squadracorsepolito/sensorboard/Doc/CubeMX_exports/sensor_board.pdf

12/03/2023

sensor_board Project
Configuration Report

## 1. Description

### 1.1. Project

Project Name | sensor_board
Board Name | custom
Generated with: | STM32CubeMX 6.6.1
Date | 03/12/2023

### 1.2. MCU

MCU Series | STM32F4
MCU Line | STM32F446
MCU name | STM32F446RETx
MCU Package | LQFP64
MCU Pin number | 64

### 1.3. Core(s) information

Core(s) | Arm Cortex-M4

## 2. Pinout Configuration

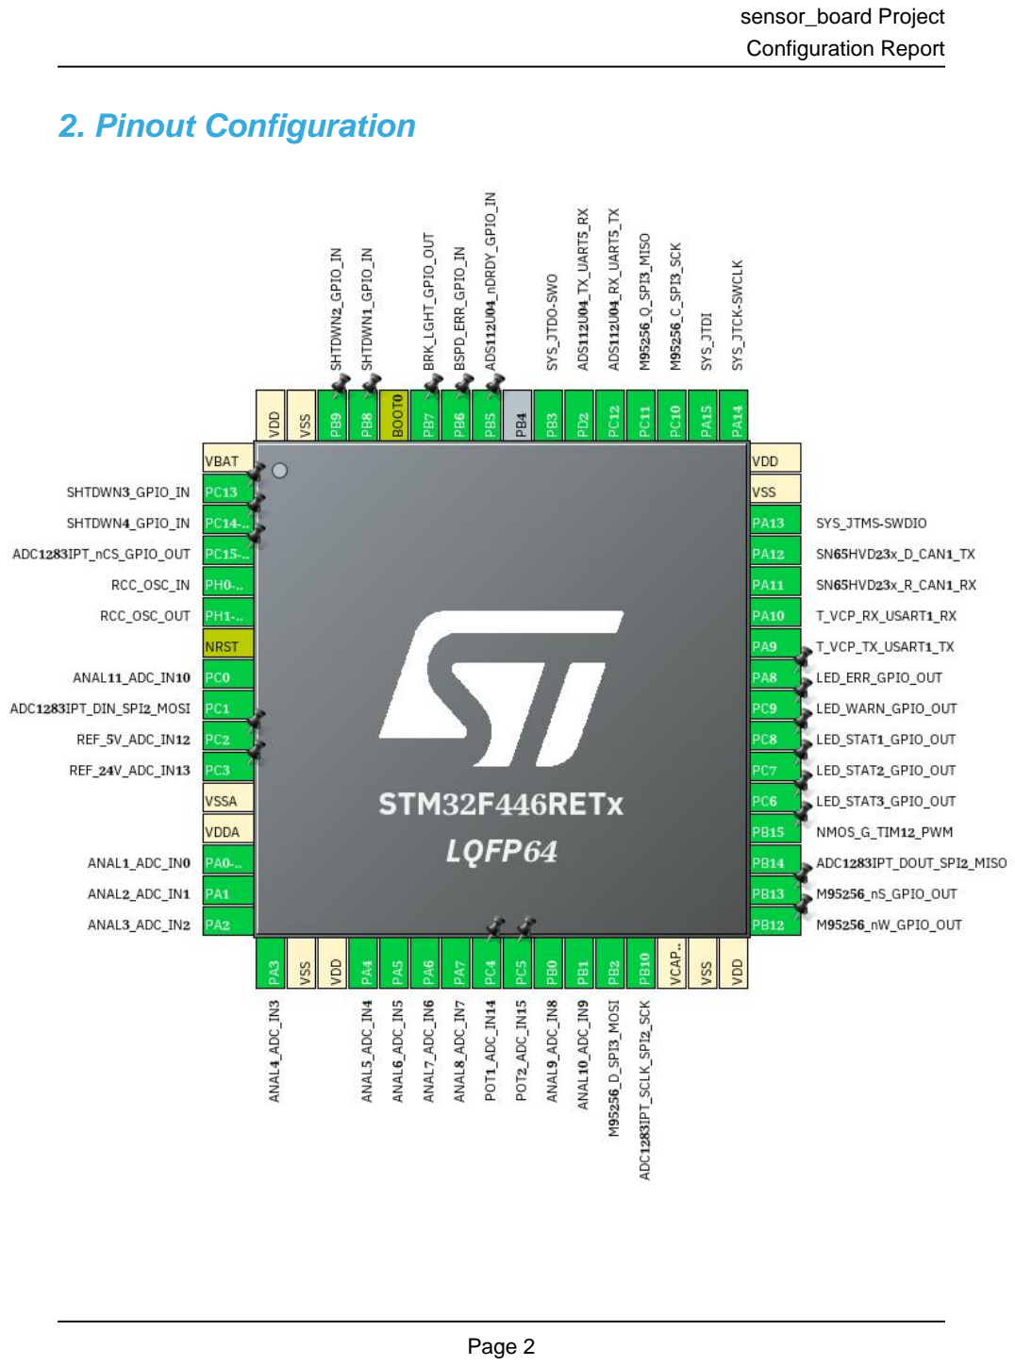
[picture p3: page 3]

## 3. Pins Configuration

Pin Number LQFP64 | Pin Name (function after reset) | Pin Type | Alternate Function(s) | Label
1 | VBAT | Power
2 | PC13 * | I/O | GPIO_Input | SHTDWN3_GPIO_IN
3 | PC14-OSC32_IN * | I/O | GPIO_Input | SHTDWN4_GPIO_IN
4 | PC15-OSC32_OUT * | I/O | GPIO_Output | ADC1283IPT_nCS_GPIO_O UT
5 | PH0-OSC_IN | I/O | RCC_OSC_IN
6 | PH1-OSC_OUT | I/O | RCC_OSC_OUT
7 | NRST | Reset
8 | PC0 | I/O | ADC1_IN10 | ANAL11_ADC_IN10
9 | PC1 | I/O | SPI2_MOSI | ADC1283IPT_DIN_SPI2_M OSI
10 | PC2 | I/O | ADC3_IN12 | REF_5V_ADC_IN12
11 | PC3 | I/O | ADC3_IN13 | REF_24V_ADC_IN13
12 | VSSA | Power
13 | VDDA | Power
14 | PA0-WKUP | I/O | ADC1_IN0 | ANAL1_ADC_IN0
15 | PA1 | I/O | ADC1_IN1 | ANAL2_ADC_IN1
16 | PA2 | I/O | ADC1_IN2 | ANAL3_ADC_IN2
17 | PA3 | I/O | ADC1_IN3 | ANAL4_ADC_IN3
18 | VSS | Power
19 | VDD | Power
20 | PA4 | I/O | ADC1_IN4 | ANAL5_ADC_IN4
21 | PA5 | I/O | ADC1_IN5 | ANAL6_ADC_IN5
22 | PA6 | I/O | ADC1_IN6 | ANAL7_ADC_IN6
23 | PA7 | I/O | ADC1_IN7 | ANAL8_ADC_IN7
24 | PC4 | I/O | ADC2_IN14 | POT1_ADC_IN14
25 | PC5 | I/O | ADC2_IN15 | POT2_ADC_IN15
26 | PB0 | I/O | ADC1_IN8 | ANAL9_ADC_IN8
27 | PB1 | I/O | ADC1_IN9 | ANAL10_ADC_IN9
28 | PB2 | I/O | SPI3_MOSI | M95256_D_SPI3_MOSI
29 | PB10 | I/O | SPI2_SCK | ADC1283IPT_SCLK_SPI2_ SCK
30 | VCAP_1 | Power
31 | VSS | Power
32 | VDD | Power
33 | PB12 * | I/O | GPIO_Output | M95256_nW_GPIO_OUT

Pin Number LQFP64 | Pin Name (function after reset) | Pin Type | Alternate Function(s) | Label
34 | PB13 * | I/O | GPIO_Output | M95256_nS_GPIO_OUT
35 | PB14 | I/O | SPI2_MISO | ADC1283IPT_DOUT_SPI2_ MISO
36 | PB15 | I/O | TIM12_CH2 | NMOS_G_TIM12_PWM
37 | PC6 * | I/O | GPIO_Output | LED_STAT3_GPIO_OUT
38 | PC7 * | I/O | GPIO_Output | LED_STAT2_GPIO_OUT
39 | PC8 * | I/O | GPIO_Output | LED_STAT1_GPIO_OUT
40 | PC9 * | I/O | GPIO_Output | LED_WARN_GPIO_OUT
41 | PA8 * | I/O | GPIO_Output | LED_ERR_GPIO_OUT
42 | PA9 | I/O | USART1_TX | T_VCP_TX_USART1_TX
43 | PA10 | I/O | USART1_RX | T_VCP_RX_USART1_RX
44 | PA11 | I/O | CAN1_RX | SN65HVD23x_R_CAN1_RX
45 | PA12 | I/O | CAN1_TX | SN65HVD23x_D_CAN1_TX
46 | PA13 | I/O | SYS_JTMS-SWDIO
47 | VSS | Power
48 | VDD | Power
49 | PA14 | I/O | SYS_JTCK-SWCLK
50 | PA15 | I/O | SYS_JTDI
51 | PC10 | I/O | SPI3_SCK | M95256_C_SPI3_SCK
52 | PC11 | I/O | SPI3_MISO | M95256_Q_SPI3_MISO
53 | PC12 | I/O | UART5_TX | ADS112U04_RX_UART5_T X
54 | PD2 | I/O | UART5_RX | ADS112U04_TX_UART5_R X
55 | PB3 | I/O | SYS_JTDO-SWO
57 | PB5 | I/O | GPIO_EXTI5 | ADS112U04_nDRDY_GPIO _IN
58 | PB6 * | I/O | GPIO_Input | BSPD_ERR_GPIO_IN
59 | PB7 * | I/O | GPIO_Output | BRK_LGHT_GPIO_OUT
60 | BOOT0 | Boot
61 | PB8 * | I/O | GPIO_Input | SHTDWN1_GPIO_IN
62 | PB9 * | I/O | GPIO_Input | SHTDWN2_GPIO_IN
63 | VSS | Power
64 | VDD | Power

* The pin is affected with an I/O function

## 4. Clock Tree Configuration

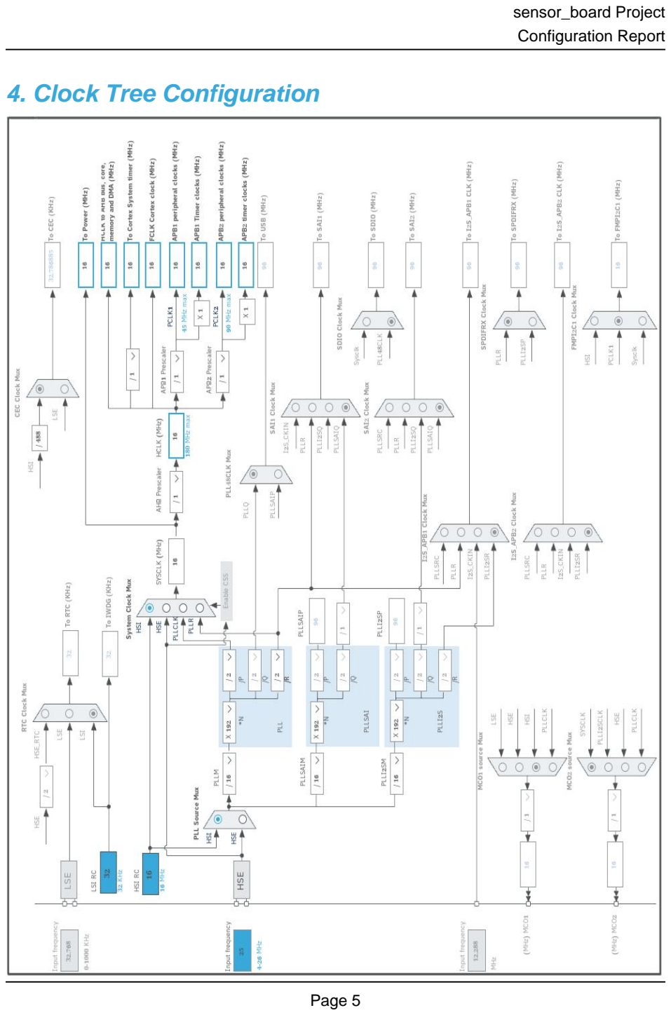
[picture p4: page 6]

## 5. Software Project

### 5.1. Project Settings

Name | Value
Project Name | sensor_board
Project Folder | /home/simone/Documents/10.SquadraCorse/Work/sensor_board
Toolchain / IDE | Makefile
Firmware Package Name and Version | STM32Cube FW_F4 V1.27.1
Application Structure | Advanced
Generate Under Root | No
Do not generate the main() | No
Minimum Heap Size | 0x200
Minimum Stack Size | 0x400

### 5.2. Code Generation Settings

Name | Value
STM32Cube MCU packages and embedded software | Copy all used libraries into the project folder
Generate peripheral initialization as a pair of '.c/.h' files | Yes
Backup previously generated files when re-generating | Yes
Keep User Code when re-generating | Yes
Delete previously generated files when not re-generated | Yes
Set all free pins as analog (to optimize the power consumption) | No
Enable Full Assert | No

### 5.3. Advanced Settings - Generated Function Calls

Rank | Function Name | Peripheral Instance Name
1 | SystemClock_Config | RCC
2 | MX_GPIO_Init | GPIO
3 | MX_ADC1_Init | ADC1
4 | MX_CAN1_Init | CAN1
5 | MX_ADC2_Init | ADC2
6 | MX_SPI2_Init | SPI2
7 | MX_SPI3_Init | SPI3
8 | MX_UART5_Init | UART5
9 | MX_USART1_UART_Init | USART1
10 | MX_ADC3_Init | ADC3
11 | MX_TIM12_Init | TIM12

## 6. Power Consumption Calculator report

### 6.1. Microcontroller Selection

Series | STM32F4
Line | STM32F446
MCU | STM32F446RETx
Datasheet | DS10693_Rev6

### 6.2. Parameter Selection

Temperature | 25
Vdd | 3.3

### 6.3. Battery Selection

Battery | Li-SOCL2(A3400)
Capacity | 3400.0 mAh
Self Discharge | 0.08 %/month
Nominal Voltage | 3.6 V
Max Cont Current | 100.0 mA
Max Pulse Current | 200.0 mA
Cells in series | 1
Cells in parallel | 1

### 6.4. Sequence

Step | Step1 | Step2
Mode | RUN | STOP_UDM (Under Drive)
Vdd | 3.3 | 3.3
Voltage Source | Battery | Battery
Range | Scale1-High | No Scale
Fetch Type | RAM/FLASH/REGON/ART/P REFETCH | n/a
CPU Frequency | 180 MHz | 0 Hz
Clock Configuration | HSE PLL | Regulator_LP Flash-PwrDwn
Clock Source Frequency | 4 MHz | 0 Hz
Peripherals
Additional Cons. | 0 mA | 0 mA
Average Current | 46 mA | 55 µA
Duration | 0.1 ms | 0.9 ms
DMIPS | 225.0 | 0.0
Ta Max | 98.02 | 104.99
Category | In DS Table | In DS Table

### 6.5. Results

Sequence Time | 1 ms | Average Current | 4.65 mA
Battery Life | 1 month | Average DMIPS | 225.0 DMIPS

### 6.6. Chart

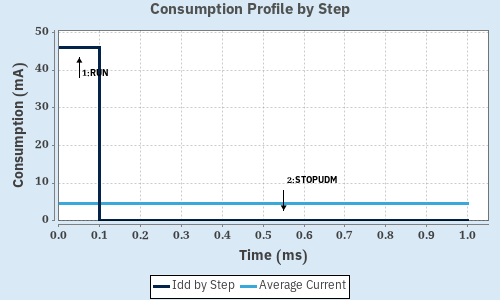
[picture p5: figure]

## 7. Peripherals and Middlewares Configuration

### 7.1. ADC1

mode: IN0
mode: IN1
mode: IN2
mode: IN3
mode: IN4
mode: IN5
mode: IN6
mode: IN7
mode: IN8
mode: IN9
mode: IN10
7.1.1. Parameter Settings:

ADCs_Common_Settings:

Mode | Independent mode
ADC_Settings:
Clock Prescaler | PCLK2 divided by 2
Resolution | 12 bits (15 ADC Clock cycles)
Data Alignment | Right alignment
Scan Conversion Mode | Disabled
Continuous Conversion Mode | Disabled
Discontinuous Conversion Mode | Disabled
DMA Continuous Requests | Disabled
End Of Conversion Selection | EOC flag at the end of single channel conversion
ADC_Regular_ConversionMode:
Number Of Conversion | 1
External Trigger Conversion Source | Regular Conversion launched by software
External Trigger Conversion Edge | None
Rank | 1
Channel | Channel 0
Sampling Time | 3 Cycles
ADC_Injected_ConversionMode:
Number Of Conversions | 0
WatchDog:
Enable Analog WatchDog Mode | false

### 7.2. ADC2

mode: IN14
mode: IN15
7.2.1. Parameter Settings:

ADCs_Common_Settings:

Mode | Independent mode
ADC_Settings:
Clock Prescaler | PCLK2 divided by 2
Resolution | 12 bits (15 ADC Clock cycles)
Data Alignment | Right alignment
Scan Conversion Mode | Disabled
Continuous Conversion Mode | Disabled
Discontinuous Conversion Mode | Disabled
DMA Continuous Requests | Disabled
End Of Conversion Selection | EOC flag at the end of single channel conversion
ADC_Regular_ConversionMode:
Number Of Conversion | 1
External Trigger Conversion Source | Regular Conversion launched by software
External Trigger Conversion Edge | None
Rank | 1
Channel | Channel 14
Sampling Time | 3 Cycles
ADC_Injected_ConversionMode:
Number Of Conversions | 0
WatchDog:
Enable Analog WatchDog Mode | false

### 7.3. ADC3

mode: IN12
mode: IN13
7.3.1. Parameter Settings:

ADC_Settings:

Clock Prescaler | PCLK2 divided by 2
Resolution | 12 bits (15 ADC Clock cycles)

Data Alignment | Right alignment
Scan Conversion Mode | Disabled
Continuous Conversion Mode | Disabled
Discontinuous Conversion Mode | Disabled
DMA Continuous Requests | Disabled
End Of Conversion Selection | EOC flag at the end of single channel conversion
ADC_Regular_ConversionMode:
Number Of Conversion | 1
External Trigger Conversion Source | Regular Conversion launched by software
External Trigger Conversion Edge | None
Rank | 1
Channel | Channel 12
Sampling Time | 3 Cycles
ADC_Injected_ConversionMode:
Number Of Conversions | 0
WatchDog:
Enable Analog WatchDog Mode | false

### 7.4. CAN1

mode: Activated
7.4.1. Parameter Settings:

Bit Timings Parameters:

Prescaler (for Time Quantum) | 16
Time Quantum | 1000.0 *
Time Quanta in Bit Segment 1 | 1 Time
Time Quanta in Bit Segment 2 | 1 Time
Time for one Bit | 3000 *
Baud Rate | 333333 *
ReSynchronization Jump Width | 1 Time
Basic Parameters:
Time Triggered Communication Mode | Disable
Automatic Bus-Off Management | Disable
Automatic Wake-Up Mode | Disable
Automatic Retransmission | Disable
Receive Fifo Locked Mode | Disable
Transmit Fifo Priority | Disable
Advanced Parameters:
Operating Mode | Normal

### 7.5. RCC

High Speed Clock (HSE): Crystal/Ceramic Resonator
7.5.1. Parameter Settings:

System Parameters:

VDD voltage (V) | 3.3
Instruction Cache | Enabled
Prefetch Buffer | Enabled
Data Cache | Enabled
Flash Latency(WS) | 0 WS (1 CPU cycle)
RCC Parameters:
HSI Calibration Value | 16
TIM Prescaler Selection | Disabled
HSE Startup Timout Value (ms) | 100
LSE Startup Timout Value (ms) | 5000
Power Parameters:
Power Regulator Voltage Scale | Power Regulator Voltage Scale 3
Power Over Drive | Disabled

### 7.6. SPI2

Mode: Full-Duplex Master
7.6.1. Parameter Settings:

Basic Parameters:

Frame Format | Motorola
Data Size | 8 Bits
First Bit | MSB First
Clock Parameters:
Prescaler (for Baud Rate) | 2
Baud Rate | 8.0 MBits/s *
Clock Polarity (CPOL) | Low
Clock Phase (CPHA) | 1 Edge
Advanced Parameters:
CRC Calculation | Disabled
NSS Signal Type | Software

### 7.7. SPI3

Mode: Full-Duplex Master
7.7.1. Parameter Settings:

Basic Parameters:

Frame Format | Motorola
Data Size | 8 Bits
First Bit | MSB First
Clock Parameters:
Prescaler (for Baud Rate) | 2
Baud Rate | 8.0 MBits/s *
Clock Polarity (CPOL) | Low
Clock Phase (CPHA) | 1 Edge
Advanced Parameters:
CRC Calculation | Disabled
NSS Signal Type | Software

### 7.8. SYS

Debug: JTAG (4 pins)
Timebase Source: SysTick

### 7.9. TIM12

Trigger Source: ITR0
Channel2: PWM Generation CH2
7.9.1. Parameter Settings:

Counter Settings:

Prescaler (PSC - 16 bits value) | 0
Counter Mode | Up
Counter Period (AutoReload Register - 16 bits value ) | 65535
Internal Clock Division (CKD) | No Division
auto-reload preload | Disable
Slave Mode Controller | Slave mode disable
PWM Generation Channel 2:
Mode | PWM mode 1

Pulse (16 bits value) | 0
Output compare preload | Enable
Fast Mode | Disable
CH Polarity | High

### 7.10. UART5

Mode: Asynchronous
7.10.1. Parameter Settings:

Basic Parameters:

Baud Rate | 115200
Word Length | 8 Bits (including Parity)
Parity | None
Stop Bits | 1
Advanced Parameters:
Data Direction | Receive and Transmit
Over Sampling | 16 Samples

### 7.11. USART1

Mode: Asynchronous
7.11.1. Parameter Settings:

Basic Parameters:

Baud Rate | 115200
Word Length | 8 Bits (including Parity)
Parity | None
Stop Bits | 1
Advanced Parameters:
Data Direction | Receive and Transmit
Over Sampling | 16 Samples

* User modified value

## 8. System Configuration

### 8.1. GPIO configuration

IP | Pin | Signal | GPIO mode | GPIO pull/up pull down

Max
Speed

User Label

ADC1 | PC0 | ADC1_IN10 | Analog mode | No pull-up and no pull-down | n/a | ANAL11_ADC_IN10
| PA0-WKUP | ADC1_IN0 | Analog mode | No pull-up and no pull-down | n/a | ANAL1_ADC_IN0
| PA1 | ADC1_IN1 | Analog mode | No pull-up and no pull-down | n/a | ANAL2_ADC_IN1
| PA2 | ADC1_IN2 | Analog mode | No pull-up and no pull-down | n/a | ANAL3_ADC_IN2
| PA3 | ADC1_IN3 | Analog mode | No pull-up and no pull-down | n/a | ANAL4_ADC_IN3
| PA4 | ADC1_IN4 | Analog mode | No pull-up and no pull-down | n/a | ANAL5_ADC_IN4
| PA5 | ADC1_IN5 | Analog mode | No pull-up and no pull-down | n/a | ANAL6_ADC_IN5
| PA6 | ADC1_IN6 | Analog mode | No pull-up and no pull-down | n/a | ANAL7_ADC_IN6
| PA7 | ADC1_IN7 | Analog mode | No pull-up and no pull-down | n/a | ANAL8_ADC_IN7
| PB0 | ADC1_IN8 | Analog mode | No pull-up and no pull-down | n/a | ANAL9_ADC_IN8
| PB1 | ADC1_IN9 | Analog mode | No pull-up and no pull-down | n/a | ANAL10_ADC_IN9
ADC2 | PC4 | ADC2_IN14 | Analog mode | No pull-up and no pull-down | n/a | POT1_ADC_IN14
| PC5 | ADC2_IN15 | Analog mode | No pull-up and no pull-down | n/a | POT2_ADC_IN15
ADC3 | PC2 | ADC3_IN12 | Analog mode | No pull-up and no pull-down | n/a | REF_5V_ADC_IN12
| PC3 | ADC3_IN13 | Analog mode | No pull-up and no pull-down | n/a | REF_24V_ADC_IN13
CAN1 | PA11 | CAN1_RX | Alternate Function Push Pull | No pull-up and no pull-down | Very High
*
| | | | | | SN65HVD23x_R_CAN1_R X
| PA12 | CAN1_TX | Alternate Function Push Pull | No pull-up and no pull-down | Very High
*
| | | | | | SN65HVD23x_D_CAN1_T X
RCC | PH0- OSC_IN | RCC_OSC_IN | n/a | n/a | n/a
| PH1- OSC_OUT | RCC_OSC_OUT | n/a | n/a | n/a
SPI2 | PC1 | SPI2_MOSI | Alternate Function Push Pull | No pull-up and no pull-down | Very High
*
| | | | | | ADC1283IPT_DIN_SPI2_ MOSI
| PB10 | SPI2_SCK | Alternate Function Push Pull | No pull-up and no pull-down | Very High
*
| | | | | | ADC1283IPT_SCLK_SPI2 _SCK
| PB14 | SPI2_MISO | Alternate Function Push Pull | No pull-up and no pull-down | Very High
*
| | | | | | ADC1283IPT_DOUT_SPI2 _MISO
SPI3 | PB2 | SPI3_MOSI | Alternate Function Push Pull | No pull-up and no pull-down | Very High
*
| | | | | | M95256_D_SPI3_MOSI
| PC10 | SPI3_SCK | Alternate Function Push Pull | No pull-up and no pull-down | Very High
*
| | | | | | M95256_C_SPI3_SCK
| PC11 | SPI3_MISO | Alternate Function Push Pull | No pull-up and no pull-down | Very High
*
| | | | | | M95256_Q_SPI3_MISO

IP | Pin | Signal | GPIO mode | GPIO pull/up pull down | Max Speed | User Label
SYS | PA13 | SYS_JTMS-SWDIO | n/a | n/a | n/a
| PA14 | SYS_JTCK-SWCLK | n/a | n/a | n/a
| PA15 | SYS_JTDI | n/a | n/a | n/a
| PB3 | SYS_JTDO-SWO | n/a | n/a | n/a
TIM12 | PB15 | TIM12_CH2 | Alternate Function Push Pull | No pull-up and no pull-down | Low | NMOS_G_TIM12_PWM
UART5 | PC12 | UART5_TX | Alternate Function Push Pull | No pull-up and no pull-down | Very High * | ADS112U04_RX_UART5_ TX
| PD2 | UART5_RX | Alternate Function Push Pull | No pull-up and no pull-down | Very High * | ADS112U04_TX_UART5_ RX
USART1 | PA9 | USART1_TX | Alternate Function Push Pull | No pull-up and no pull-down | Very High * | T_VCP_TX_USART1_TX
| PA10 | USART1_RX | Alternate Function Push Pull | No pull-up and no pull-down | Very High * | T_VCP_RX_USART1_RX
GPIO | PC13 | GPIO_Input | Input mode | No pull-up and no pull-down | n/a | SHTDWN3_GPIO_IN
PC14-OSC32_IN | GPIO_Input | Input mode | No pull-up and no pull-down | n/a | SHTDWN4_GPIO_IN
PC15-OSC32_OU T | GPIO_Output | Output Push Pull | No pull-up and no pull-down | Low | ADC1283IPT_nCS_GPIO_ OUT
PB12 | GPIO_Output | Output Push Pull | No pull-up and no pull-down | Low | M95256_nW_GPIO_OUT
PB13 | GPIO_Output | Output Push Pull | No pull-up and no pull-down | Low | M95256_nS_GPIO_OUT
PC6 | GPIO_Output | Output Push Pull | No pull-up and no pull-down | Low | LED_STAT3_GPIO_OUT
PC7 | GPIO_Output | Output Push Pull | No pull-up and no pull-down | Low | LED_STAT2_GPIO_OUT
PC8 | GPIO_Output | Output Push Pull | No pull-up and no pull-down | Low | LED_STAT1_GPIO_OUT
PC9 | GPIO_Output | Output Push Pull | No pull-up and no pull-down | Low | LED_WARN_GPIO_OUT
PA8 | GPIO_Output | Output Push Pull | No pull-up and no pull-down | Low | LED_ERR_GPIO_OUT
PB5 | GPIO_EXTI5 | External Interrupt Mode with Rising edge trigger detection | No pull-up and no pull-down | n/a | ADS112U04_nDRDY_GPI O_IN
PB6 | GPIO_Input | Input mode | No pull-up and no pull-down | n/a | BSPD_ERR_GPIO_IN
PB7 | GPIO_Output | Output Push Pull | No pull-up and no pull-down | Low | BRK_LGHT_GPIO_OUT
PB8 | GPIO_Input | Input mode | No pull-up and no pull-down | n/a | SHTDWN1_GPIO_IN
PB9 | GPIO_Input | Input mode | No pull-up and no pull-down | n/a | SHTDWN2_GPIO_IN

### 8.2. DMA configuration

nothing configured in DMA service

### 8.3. NVIC configuration

8.3.1. NVIC
Interrupt Table | Enable | Preenmption Priority | SubPriority
Non maskable interrupt | true | 0 | 0
Hard fault interrupt | true | 0 | 0
Memory management fault | true | 0 | 0
Pre-fetch fault, memory access fault | true | 0 | 0
Undefined instruction or illegal state | true | 0 | 0
System service call via SWI instruction | true | 0 | 0
Debug monitor | true | 0 | 0
Pendable request for system service | true | 0 | 0
System tick timer | true | 15 | 0
PVD interrupt through EXTI line 16 | unused
Flash global interrupt | unused
RCC global interrupt | unused
ADC1, ADC2 and ADC3 interrupts | unused
CAN1 TX interrupt | unused
CAN1 RX0 interrupt | unused
CAN1 RX1 interrupt | unused
CAN1 SCE interrupt | unused
EXTI line[9:5] interrupts | unused
SPI2 global interrupt | unused
USART1 global interrupt | unused
TIM8 break interrupt and TIM12 global interrupt | unused
SPI3 global interrupt | unused
UART5 global interrupt | unused
FPU global interrupt | unused
8.3.2. NVIC Code generation
Enabled interrupt Table | Select for init sequence ordering | Generate IRQ handler | Call HAL handler
Non maskable interrupt | false | true | false
Hard fault interrupt | false | true | false
Memory management fault | false | true | false
Pre-fetch fault, memory access fault | false | true | false
Undefined instruction or illegal state | false | true | false
System service call via SWI instruction | false | true | false
Debug monitor | false | true | false
Pendable request for system service | false | true | false
System tick timer | false | true | true

* User modified value

## 9. System Views

9.1. Category view
9.1.1. Current

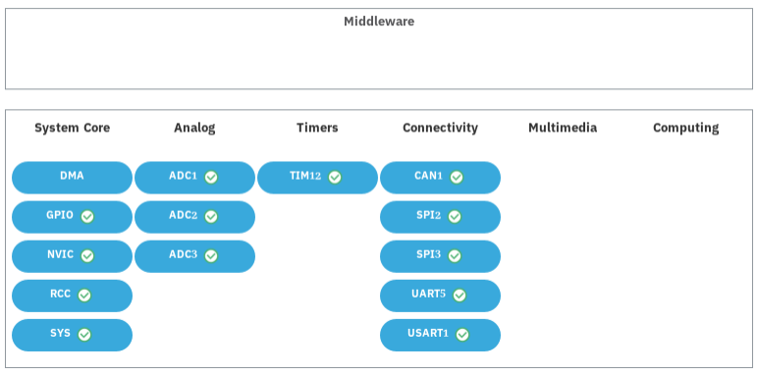
[picture p6: figure]

## 10. Docs & Resources

Type | Link
BSDL files | https://www.st.com/resource/en/bsdl_model/stm32f446_bsdl.zip
IBIS models | https://www.st.com/resource/en/ibis_model/stm32f446_ibis.zip
System View Description | https://www.st.com/resource/en/svd/stm32f4_svd.zip
BSDL files | https://www.st.com/resource/en/bsdl_model/stm32f446_bsdl.zip
IBIS models | https://www.st.com/resource/en/ibis_model/stm32f446_ibis.zip
System View Description | https://www.st.com/resource/en/svd/stm32f4_svd.zip
Presentations | https://www.st.com/resource/en/product_presentation/stm32-stm8_embedded_software_solutions.pdf
Presentations | https://www.st.com/resource/en/product_presentation/stm32_eval-tools_portfolio.pdf
Presentations | https://www.st.com/resource/en/product_presentation/stm32_stm8_functi onal-safety-packages.pdf
Presentations | https://www.st.com/resource/en/product_presentation/stm32-stm8_software_development_tools.pdf
Training Material | https://www.st.com/resource/en/sales_guide/sg_sc2154.pdf
Flyers | https://www.st.com/resource/en/flyer/flstm32nucleo.pdf
Flyers | https://www.st.com/resource/en/flyer/flstmcsuite.pdf
Flyers | https://www.st.com/resource/en/flyer/flstm32trust.pdf
Product Certifications | https://www.st.com/resource/en/certification_document/stm32_authentication_can.pdf
Application Notes | https://www.st.com/resource/en/application_note/an1181-electrostatic-discharge-sensitivity-measurement-stmicroelectronics.pdf
Application Notes | https://www.st.com/resource/en/application_note/an1709-emc-design-guide-for-stm8-stm32-and-legacy-mcus-stmicroelectronics.pdf
Application Notes | https://www.st.com/resource/en/application_note/an2606-stm32-microcontroller-system-memory-boot-mode-stmicroelectronics.pdf

Application Notes | https://www.st.com/resource/en/application_note/an2639-soldering-recommendations-and-package-information-for-leadfree-ecopack-mcus-and-mpus-stmicroelectronics.pdf
Application Notes | https://www.st.com/resource/en/application_note/an2834-how-to-get-the-best-adc-accuracy-in-stm32-microcontrollers-stmicroelectronics.pdf
Application Notes | https://www.st.com/resource/en/application_note/an2867-oscillator-design-guide-for-stm8afals-stm32-mcus-and-mpus-stmicroelectronics.pdf
Application Notes | https://www.st.com/resource/en/application_note/an2945-stm8s-and-stm32-mcus-a-consistent-832bit-product-line-for-painless-migration-stmicroelectronics.pdf
Application Notes | https://www.st.com/resource/en/application_note/an3070-managing-the-driver-enable-signal-for-rs485-and-iolink-communications-with-the-stm32s-usart-stmicroelectronics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
Application Notes | https://www.st.com/resource/en/application_note/an3126-audio-and-waveform-generation-using-the-dac-in-stm32-products-stmicroelectronics.pdf
Application Notes | https://www.st.com/resource/en/application_note/an3154-can-protocol-used-in-the-stm32-bootloader-stmicroelectronics.pdf
Application Notes | https://www.st.com/resource/en/application_note/an3155-usart-protocol-used-in-the-stm32-bootloader-stmicroelectronics.pdf
Application Notes | https://www.st.com/resource/en/application_note/an3156-usb-dfu-protocol-used-in-the-stm32-bootloader-stmicroelectronics.pdf
Application Notes | https://www.st.com/resource/en/application_note/an3364-migration-and-compatibility-guidelines-for-stm32-microcontroller-applications-stmicroelectronics.pdf
Application Notes | https://www.st.com/resource/en/application_note/an3997-audio-playback-and-recording-using-the-stm32f4discovery-stmicroelectronics.pdf
Application Notes | https://www.st.com/resource/en/application_note/an3998-pdm-audio-software-decoding-on-stm32-microcontrollers-stmicroelectronics.pdf
Application Notes | https://www.st.com/resource/en/application_note/an4013-stm32-crossseries-timer-overview-stmicroelectronics.pdf
Application Notes | https://www.st.com/resource/en/application_note/an4031-using-the- stm32f2-stm32f4-and-stm32f7-series-dma-controller-

| stmicroelectronics.pdf
Application Notes | https://www.st.com/resource/en/application_note/an4221-i2c-protocol-used-in-the-stm32-bootloader-stmicroelectronics.pdf
Application Notes | https://www.st.com/resource/en/application_note/an4229-how-to-implement-a-vocoder-solution-using-stm32-microcontrollers-stmicroelectronics.pdf
Application Notes | https://www.st.com/resource/en/application_note/an4230-stm32-microcontroller-random-number-generation-validation-using-the-nist-statistical-test-suite-stmicroelectro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
Application Notes | https://www.st.com/resource/en/application_note/an4277-using-stm32-device-pwm-shutdown-features-for-motor-control-and-digital-power-conversion-stmicroelectronics.pdf
Application Notes | https://www.st.com/resource/en/application_note/an4286-spi-protocol-used-in-the-stm32-bootloader-stmicroelectronics.pdf
Application Notes | https://www.st.com/resource/en/application_note/an4488-getting-started-with-stm32f4xxxx-mcu-hardware-development-stmicroelectronics.pdf
Application Notes | https://www.st.com/resource/en/application_note/an4566-extending-the-dac-performance-of-stm32-microcontrollers-stmicroelectronics.pdf
Application Notes | https://www.st.com/resource/en/application_note/an4640-peripherals-interconnections-on-stm32f4057xx-stm32f4157xx-stm32f42xxx-stm32f43xxx-stm32f446xx-and-stm32f469479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
Application Notes | https://www.st.com/resource/en/application_note/an4655-virtually-increasing-the-number-of-serial-communication-peripherals-in-stm32-applications-stmicroelectronics.p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
Application Notes | https://www.st.com/resource/en/application_note/an4658-migration-of-applications-from-stm32f429439-lines-to-stm32f446-line-stmicroelectronics.pdf
Application Notes | https://www.st.com/resource/en/application_note/an4739-stm32cube-firmware-examples-for-stm32f4-series-stmicroelectronics.pdf
Application Notes | https://www.st.com/resource/en/application_note/an4750-handling-of-soft-errors-in-stm32-applications-stmicroelectronics.pdf
Application Notes | https://www.st.com/resource/en/application_note/an4759-using-the- hardware-realtime-clock-rtc-and-the-tamper-management-unit-tamp-with-

| stm32-microcontrollers-stmicroelectronics.pdf
Application Notes | https://www.st.com/resource/en/application_note/an4776-generalpurpose-timer-cookbook-for-stm32-microcontrollers-stmicroelectronics.pdf
Application Notes | https://www.st.com/resource/en/application_note/an4803-highspeed-si-simulations-using-ibis-and-boardlevel-simulations-using-hyperlynx-si-on-stm32-mcus-and-mpus-stmic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
Application Notes | https://www.st.com/resource/en/application_note/an4838-managing-memory-protection-unit-in-stm32-mcus-stmicroelectronics.pdf
Application Notes | https://www.st.com/resource/en/application_note/an4850-stm32-mcus-spreadspectrum-clock-generation-principles-properties-and-implementation-stmicroelectronics.pdf
Application Notes | https://www.st.com/resource/en/application_note/an4879-usb-hardware-and-pcb-guidelines-using-stm32-mcus-stmicroelectronics.pdf
Application Notes | https://www.st.com/resource/en/application_note/an4908-stm32-usart-automatic-baud-rate-detection-stmicroelectronics.pdf
Application Notes | https://www.st.com/resource/en/application_note/an4989-stm32-microcontroller-debug-toolbox-stmicroelectronics.pdf
Application Notes | https://www.st.com/resource/en/application_note/an4995-using-an-electromyogram-technique-to-detect-muscle-activity-stmicroelectronics.pdf
Application Notes | https://www.st.com/resource/en/application_note/an5020-digital-camera-interface-dcmi-on-stm32-mcus-stmicroelectronics.pdf
Application Notes | https://www.st.com/resource/en/application_note/an5027-interfacing-pdm-digital-microphones-using-stm32-mcus-and-mpus-stmicroelectronics.pdf
Application Notes | https://www.st.com/resource/en/application_note/an5036-thermal-management-guidelines-for-stm32-applications-stmicroelectronics.pdf
Application Notes | https://www.st.com/resource/en/application_note/an5073-receiving-spdif-audio-stream-with-the-stm32f4f7h7-series-stmicroelectronics.pdf
Application Notes | https://www.st.com/resource/en/application_note/an5156-introduction-to-stm32-microcontrollers-security-stmicroelectronics.pdf
Application Notes | https://www.st.com/resource/en/application_note/an5225-usb-typec-power-delivery-using-stm32-mcus-and-mpus-stmicroelectronics.pdf
Application Notes | https://www.st.com/resource/en/application_note/an5543-enhanced-

| methods-to-handle-spi-communication-on-stm32-devices-stmicroelectronics.pdf
Application Notes | https://www.st.com/resource/en/application_note/an4760-quadspi-interface-on-stm32-microcontrollers-and-microprocessors--stmicroelectronics.pdf
Application Notes | https://www.st.com/resource/en/application_note/an4899-stm32-microcontroller-gpio-hardware-settings-and-lowpower-consumption-stmicroelectronics.pdf
Application Notes | https://www.st.com/resource/en/application_note/an5612-esd-protection-of-stm32-mcus-and-mpus-stmicroelectronics.pdf
Application Notes for related Tools & Software | https://www.st.com/resource/en/application_note/an1202_freertos_guide-freertos-guide-stmicroelectronics.pdf
Application Notes for related Tools & Software | https://www.st.com/resource/en/application_note/an1602_semihosting_in_truestudio-how-to-do-semihosting-in-truestudio-stmicroelectronics.pdf
Application Notes for related Tools & Software | https://www.st.com/resource/en/application_note/an1801_stm32cubeprogrammer_in_truestudio-installing-stm32cubeprogrammer-in-truestudio-stmicroelectronics.pdf
Application Notes for related Tools & Software | https://www.st.com/resource/en/application_note/atollic_editing_keyboard_shortcuts-atollic-editing-keyboard-shortcuts-stmicroelectronics.pdf
Application Notes for related Tools & Software | https://www.st.com/resource/en/application_note/iar_to_atollic_truestudio_migration_guide-truestudio-for-arm-migration-guide-iar-embedded-workbench-to-truestudio-stm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
Application Notes for related Tools & Software | https://www.st.com/resource/en/application_note/stm32cubemx_installation_in_truestudio-stm32cubemx-installation-in-truestudio-stmicroelectronics.pdf
Application Notes for related Tools & Software | https://www.st.com/resource/en/application_note/an2656-stm32f10xxx-lcd-glass-driver-firmware-stmicroelectronics.pdf
Application Notes for related Tools & Software | https://www.st.com/resource/en/application_note/an2790-tft-lcd-interfacing-with-the-highdensity-stm32f10xxx-fsmc-stmicroelectronics.pdf

Application Notes for related Tools & Software | https://www.st.com/resource/en/application_note/an3078-stm32-inapplication-programming-over-the-ic-bus-stmicroelectronics.pdf
Application Notes for related Tools & Software | https://www.st.com/resource/en/application_note/an3116-stm32s-adc-modes-and-their-applications-stmicroelectronics.pdf
Application Notes for related Tools & Software | https://www.st.com/resource/en/application_note/an3174-implementing-receivers-for-infrared-remote-control-protocols-using-stm32f10xxx-microcontrollers-stmicroelectro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
Application Notes for related Tools & Software | https://www.st.com/resource/en/application_note/an3241-qvga-tftlcd-direct-drive-using-the-stm32f10xx-fsmc-peripheral-stmicroelectronics.pdf
Application Notes for related Tools & Software | https://www.st.com/resource/en/application_note/an3307-guidelines-for-obtaining-iec-60335-class-b-certification-for-any-stm32-application-stmicroelectronics.pdf
Application Notes for related Tools & Software | https://www.st.com/resource/en/application_note/an3364-migration-and-compatibility-guidelines-for-stm32-microcontroller-applications-stmicroelectronics.pdf
Application Notes for related Tools & Software | https://www.st.com/resource/en/application_note/an3965-stm32f40xstm32f41x-inapplication-programming-using-the-usart-stmicroelectronics.pdf
Application Notes for related Tools & Software | https://www.st.com/resource/en/application_note/an3969-eeprom-emulation-in-stm32f40xstm32f41x-microcontrollers-stmicroelectronics.pdf
Application Notes for related Tools & Software | https://www.st.com/resource/en/application_note/an3990-upgrading-stm32f4discovery-board-firmware-using-a-usb-key-stmicroelectronics.pdf
Application Notes for related Tools & Software | https://www.st.com/resource/en/application_note/an3997-audio-playback-and-recording-using-the-stm32f4discovery-stmicroelectronics.pdf
Application Notes for related Tools & Software | https://www.st.com/resource/en/application_note/an3998-pdm-audio-software-decoding-on-stm32-microcontrollers-stmicroelectronics.pdf
Application Notes | https://www.st.com/resource/en/application_note/an4044-floating-point-

for related Tools & Software | unit-demonstration-on-stm32-microcontrollers-stmicroelectronics.pdf
Application Notes for related Tools & Software | https://www.st.com/resource/en/application_note/an4187-using-the-crc-peripheral-in-the-stm32-family-stmicroelectronics.pdf
Application Notes for related Tools & Software | https://www.st.com/resource/en/application_note/an4323-getting-started-with-stemwin-library-stmicroelectronics.pdf
Application Notes for related Tools & Software | https://www.st.com/resource/en/application_note/an4365-using-stm32f4-mcu-power-modes-with-best-dynamic-efficiency-stmicroelectronics.pdf
Application Notes for related Tools & Software | https://www.st.com/resource/en/application_note/an4435-guidelines-for-obtaining-ulcsaiec-607301603351-class-b-certification-in-any-stm32-application-stmicroelectroni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
Application Notes for related Tools & Software | https://www.st.com/resource/en/application_note/an4457-implementing-an-emulated-uart-on-stm32f4-microcontrollers-stmicroelectronics.pdf
Application Notes for related Tools & Software | https://www.st.com/resource/en/application_note/an4499-stm32--nrf51822-bluetooth-low-energy-system-solution-stmicroelectronics.pdf
Application Notes for related Tools & Software | https://www.st.com/resource/en/application_note/an4502-stm32-smbuspmbus-embedded-software-expansion-for-stm32cube-stmicroelectronics.pdf
Application Notes for related Tools & Software | https://www.st.com/resource/en/application_note/an4657-stm32-inapplication-programming-iap-using-the-usart-stmicroelectronics.pdf
Application Notes for related Tools & Software | https://www.st.com/resource/en/application_note/an4666-parallel-synchronous-transmission-using-gpio-and-dma-stmicroelectronics.pdf
Application Notes for related Tools & Software | https://www.st.com/resource/en/application_note/an4678-full-duplex-spi-emulation-for-stm32f4-microcontrollers-stmicroelectronics.pdf

Application Notes
for related Tools

https://www.st.com/resource/en/application_note/an4701-proprietarycode-readout-protection-on-microcontrollers-of-the-stm32f4-series-

& Software | stmicroelectronics.pdf
Application Notes for related Tools & Software | https://www.st.com/resource/en/application_note/an4739-stm32cube-firmware-examples-for-stm32f4-series-stmicroelectronics.pdf
Application Notes for related Tools & Software | https://www.st.com/resource/en/application_note/an4758-proprietary-code-readout-protection-on-stm32l4-stm32l4-stm32g4-and-stm32wb-series-mcus-stmicroelectronics.pdf
Application Notes for related Tools & Software | https://www.st.com/resource/en/application_note/an4759-using-the-hardware-realtime-clock-rtc-and-the-tamper-management-unit-tamp-with-stm32-microcontrollers-stmicroe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
Application Notes for related Tools & Software | https://www.st.com/resource/en/application_note/an4841-digital-signal-processing-for-stm32-microcontrollers-using-cmsis-stmicroelectronics.pdf
Application Notes for related Tools & Software | https://www.st.com/resource/en/application_note/an4852-programming-an-external-flash-memory-using-the-uart-bootloader-builtin-stm32-microcontrollers-stmicroelectroni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
Application Notes for related Tools & Software | https://www.st.com/resource/en/application_note/an4968-proprietary-code-read-out-protection-pcrop-on-stm32f72xxx-and-stm32f73xxx-microcontrollers-stmicroelectronics.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
Application Notes for related Tools & Software | https://www.st.com/resource/en/application_note/an5054-secure-programming-using-stm32cubeprogrammer-stmicroelectronics.pdf
Application Notes for related Tools & Software | https://www.st.com/resource/en/application_note/an5056-integration-guide-for-the-xcubesbsfu-stm32cube-expansion-package-stmicroelectronics.pdf
Application Notes for related Tools & Software | https://www.st.com/resource/en/application_note/an5360-getting-started-with-projects-based-on-the-stm32mp1-series-in-stm32cubeide-stmicroelectronics.pdf
Application Notes for related Tools & Software | https://www.st.com/resource/en/application_note/an5361-getting-started-with-projects-based-on-dualcore-stm32h7-microcontrollers-in-stm32cubeide-stmicroelectronics.pd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
Application Notes for related Tools & Software | https://www.st.com/resource/en/application_note/an5394-getting-started-with-projects-based-on-the-stm32l5-series-in-stm32cubeide-stmicroelectronics.pdf

Application Notes for related Tools & Software | https://www.st.com/resource/en/application_note/an5418-how-to-build-a-simple-usbpd-sink-application-with-stm32cubemx-stmicroelectronics.pdf
Application Notes for related Tools & Software | https://www.st.com/resource/en/application_note/an5426-migrating-graphics-middleware-projects-from-stm32cubemx-540-to-stm32cubemx-550-stmicroelectronics.pdf
Application Notes for related Tools & Software | https://www.st.com/resource/en/application_note/an5464-position-control-of-a-threephase-permanent-magnet-motor-using-xcubemcsdk-or-xcubemcsdkful-stmicroelectronics.p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
Application Notes for related Tools & Software | https://www.st.com/resource/en/application_note/an5564-getting-started-with-projects-based-on-dualcore-stm32wl-microcontrollers-in-stm32cubeide-stmicroelectronics.pd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
Application Notes for related Tools & Software | https://www.st.com/resource/en/application_note/an5698-adapting-the-xcubestl-functional-safety-package-for-stm32-iec-61508-compliant-to-other-safety-standards-stmicr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
Application Notes for related Tools & Software | https://www.st.com/resource/en/application_note/an5731-stm32cubemx-and-stm32cubeide-threadsafe-solution-stmicroelectronics.pdf
Errata Sheets | https://www.st.com/resource/en/errata_sheet/es0298-stm32f446xcxe-device-limitations-stmicroelectronics.pdf
Datasheet | https://www.st.com/resource/en/datasheet/dm00141306.pdf
Programming Manuals | https://www.st.com/resource/en/programming_manual/pm0214-stm32-cortexm4-mcus-and-mpus-programming-manual-stmicroelectronics.pdf
Reference Manuals | https://www.st.com/resource/en/reference_manual/rm0390-stm32f446xx-advanced-armbased-32bit-mcus-stmicroelectronics.pdf
Technical Notes & Articles | https://www.st.com/resource/en/technical_note/tn0516-overview-of-the-stm32f0xf100xxf103xx-and-stm32f2xxf30xf4xx-mcus-pmsm-singledual-foc-sdk-v40-stmicroelectronics.p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
Technical Notes & Articles | https://www.st.com/resource/en/technical_note/tn1163-description-of-wlcsp-for-microcontrollers-and-recommendations-for-its-use-stmicroelectronics.pdf
Technical Notes & Articles | https://www.st.com/resource/en/technical_note/tn1204-tape-and-reel-shipping-media-for-stm32-microcontrollers-in-bga-packages-stmicroelectronics.pdf

Technical Notes & Articles | https://www.st.com/resource/en/technical_note/tn1205-tape-and-reel-shipping-media-for-stm8-and-stm32-microcontrollers-in-fpn-packages-stmicroelectronics.pdf
Technical Notes & Articles | https://www.st.com/resource/en/technical_note/tn1206-tape-and-reel-shipping-media-for-stm8-and-stm32-microcontrollers-in-qfp-packages-stmicroelectronics.pdf
Technical Notes & Articles | https://www.st.com/resource/en/technical_note/tn1207-tape-and-reel-shipping-media-for-stm8-and-stm32-microcontrollers-in-so-packages-stmicroelectronics.pdf
Technical Notes & Articles | https://www.st.com/resource/en/technical_note/tn1208-tape-and-reel-shipping-media-for-stm8-and-stm32-microcontrollers-in-tssop-and-ssop-packages-stmicroelectronics.p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
