squadracorsepolito/sensorboard/Doc/Schematic_v3.pdf

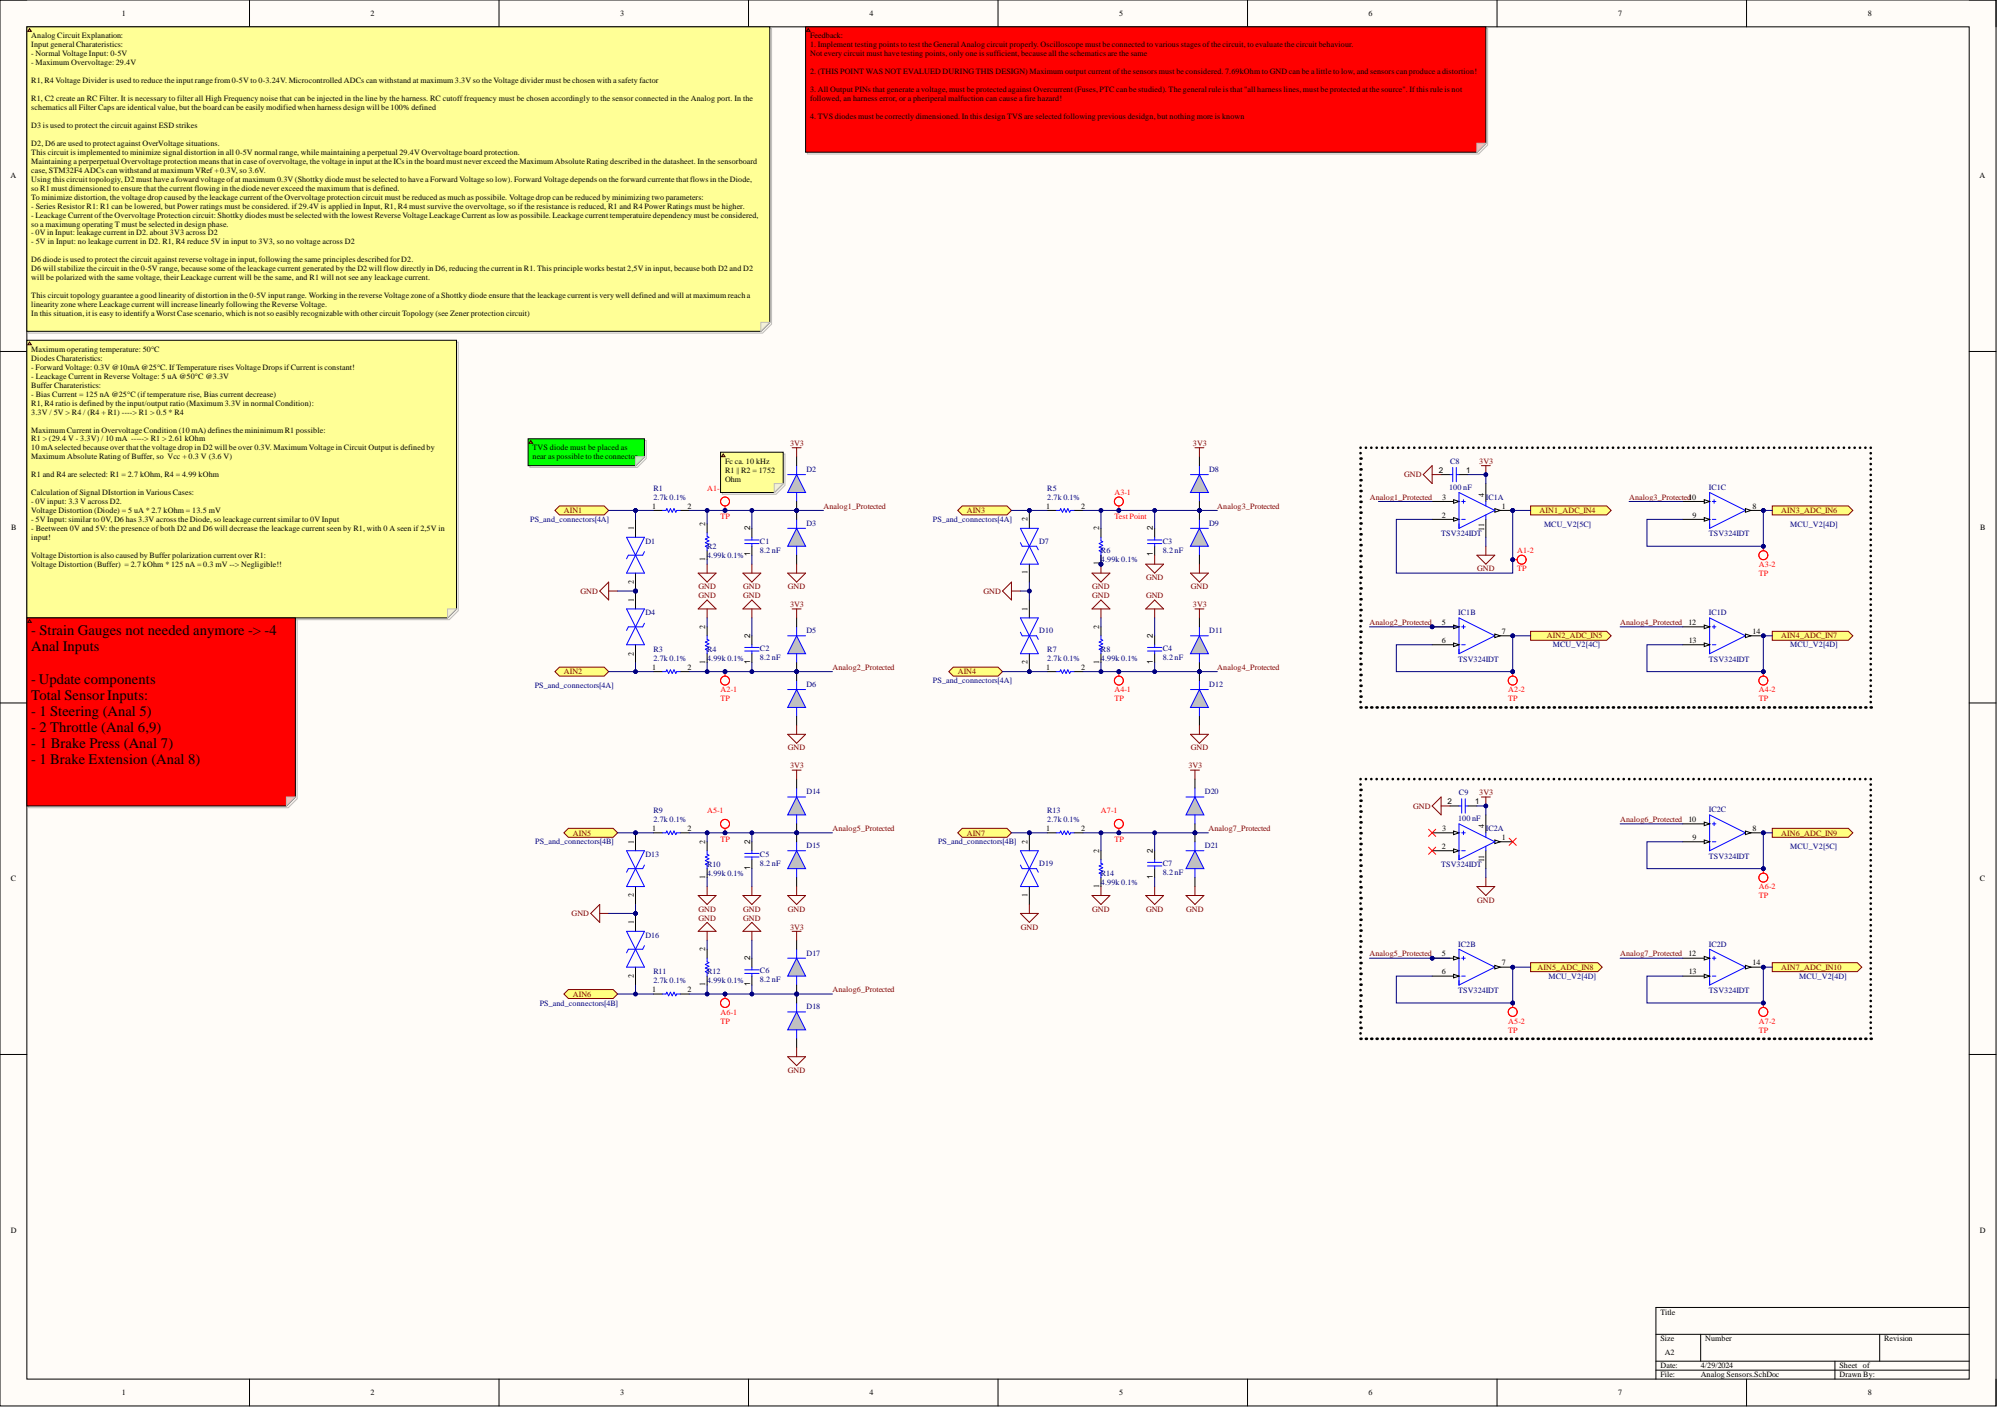
[picture p7: page 1]

R1, C2 create an RC Fi

uced as much as

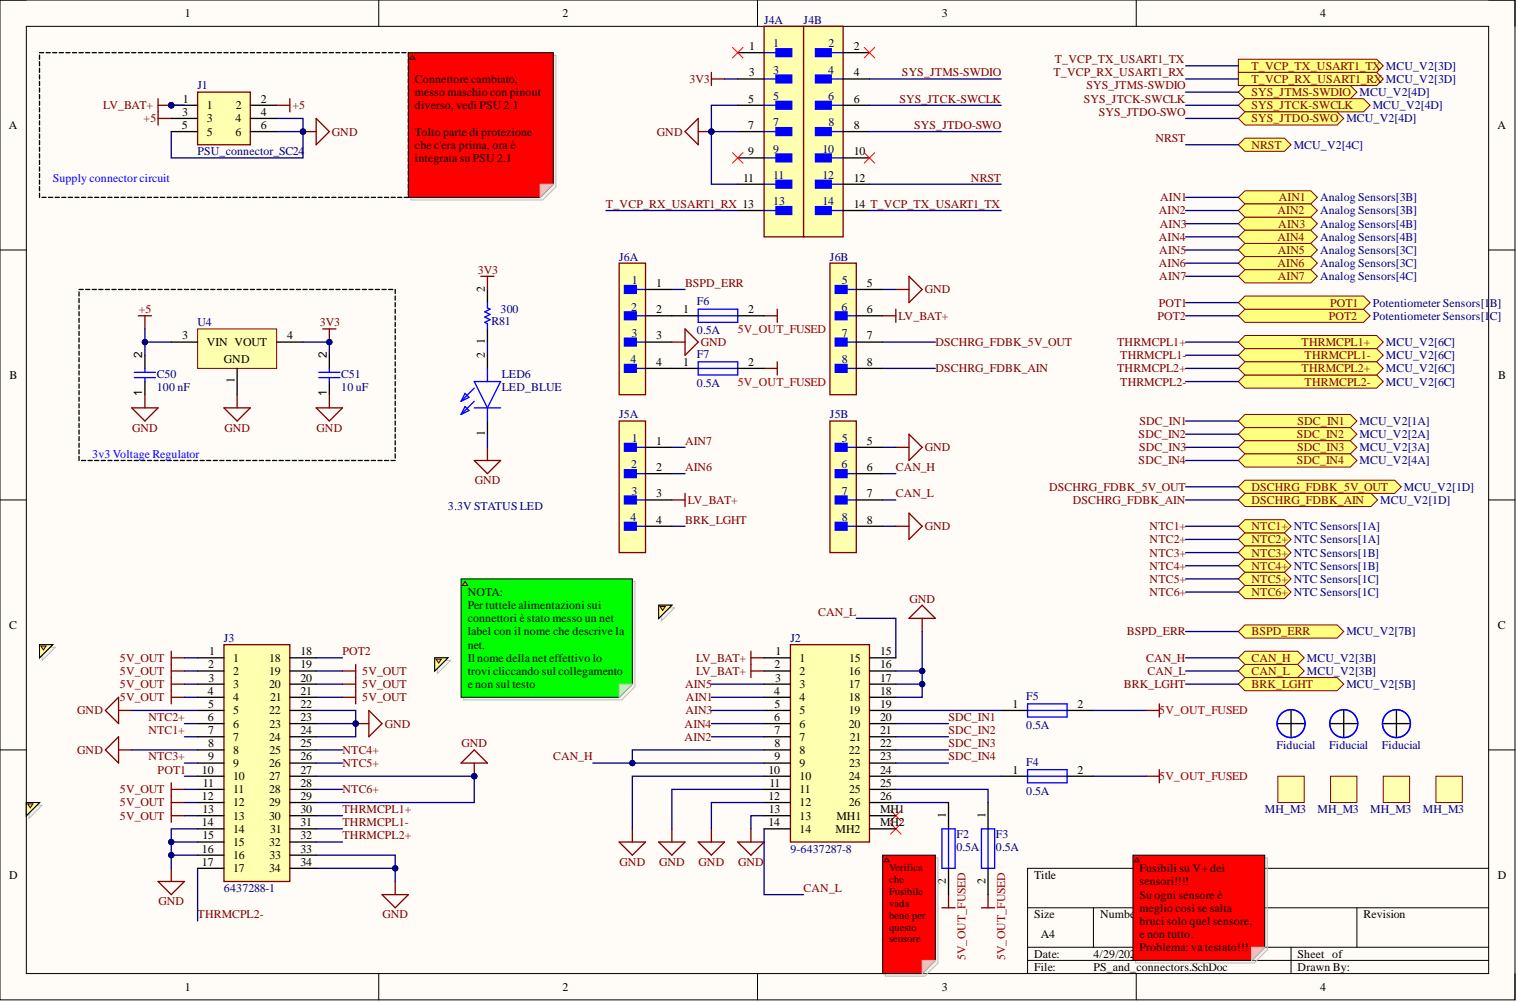
[picture p8: page 2]

Connettore cambiato,
messo maschio con pinout
diverso, vedi PSU 2.1

Tolto parte di protezione
che c'era prima, ora è
integrata su PSU 2.1

NOTA:
Per tuttele alimentazioni sui
connettori è stato messo un net
label con il nome che descrive la
net.
Il nome della net effettivo lo
trovi cliccando sul collegamento
e non sul testo

Fusibili su V+ dei
sensori!!!!
Su ogni sensore è
meglio così se salta
brucisolo quelsensore,
e non tutto.
Problema: va testato!!!

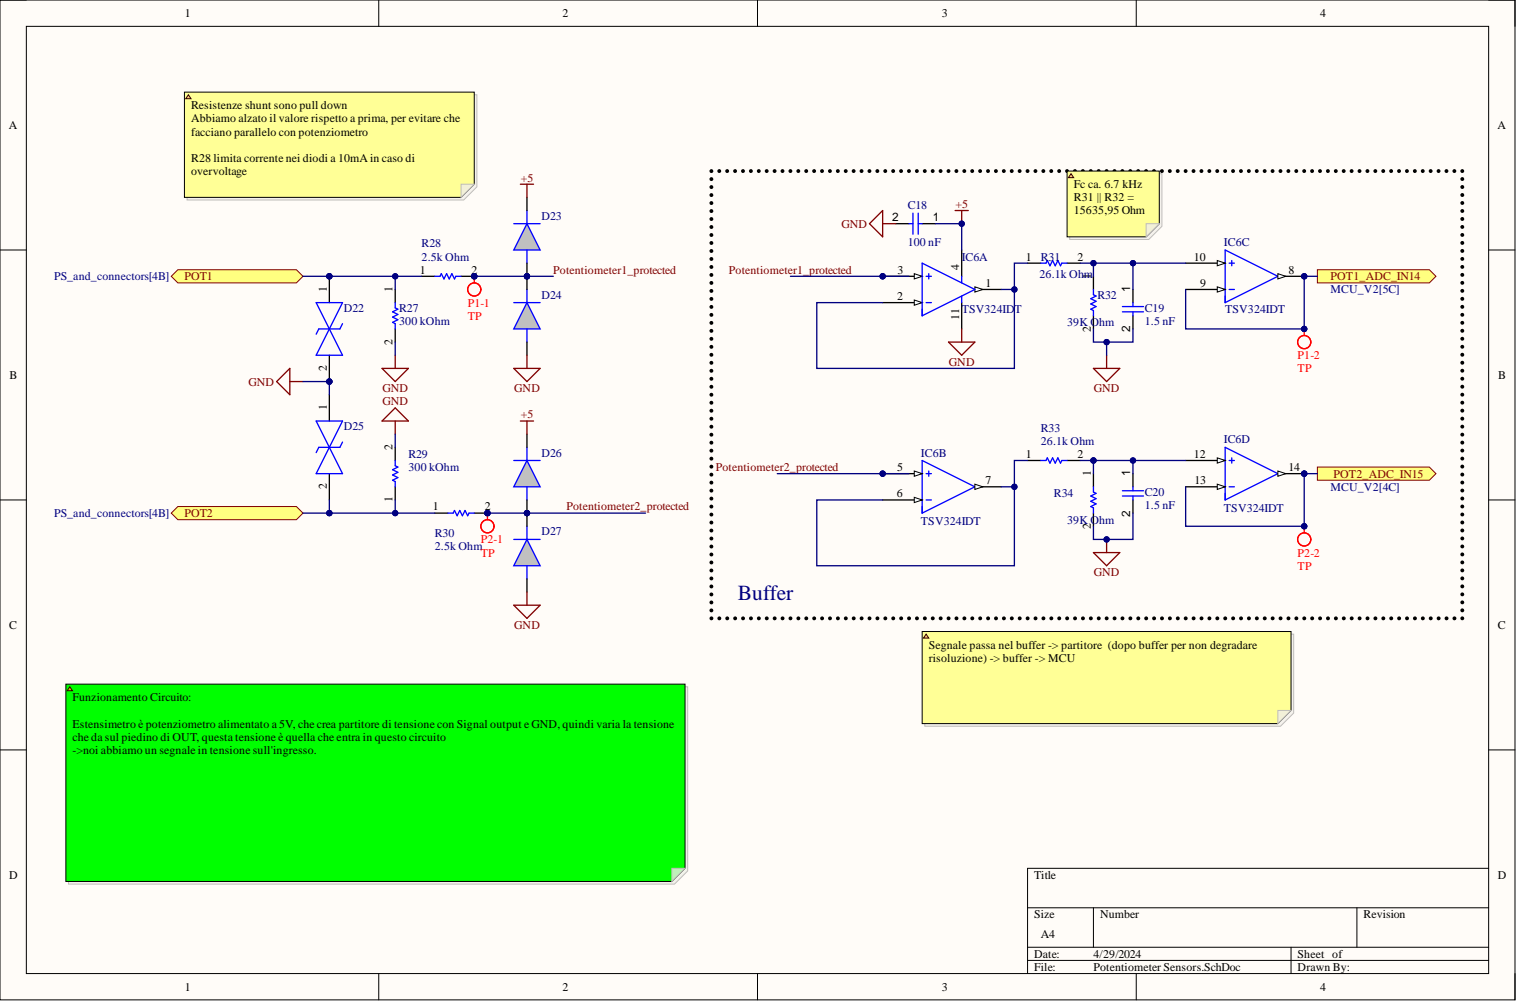
[picture p9: page 3]
ometer Sen; uffer ->; ore (d; uffer -> MCU; iamo alzat; ore ri; per ev; tare che; ta corren; n cas; o Circu; ometro al; V, che crea; o circu

la che en

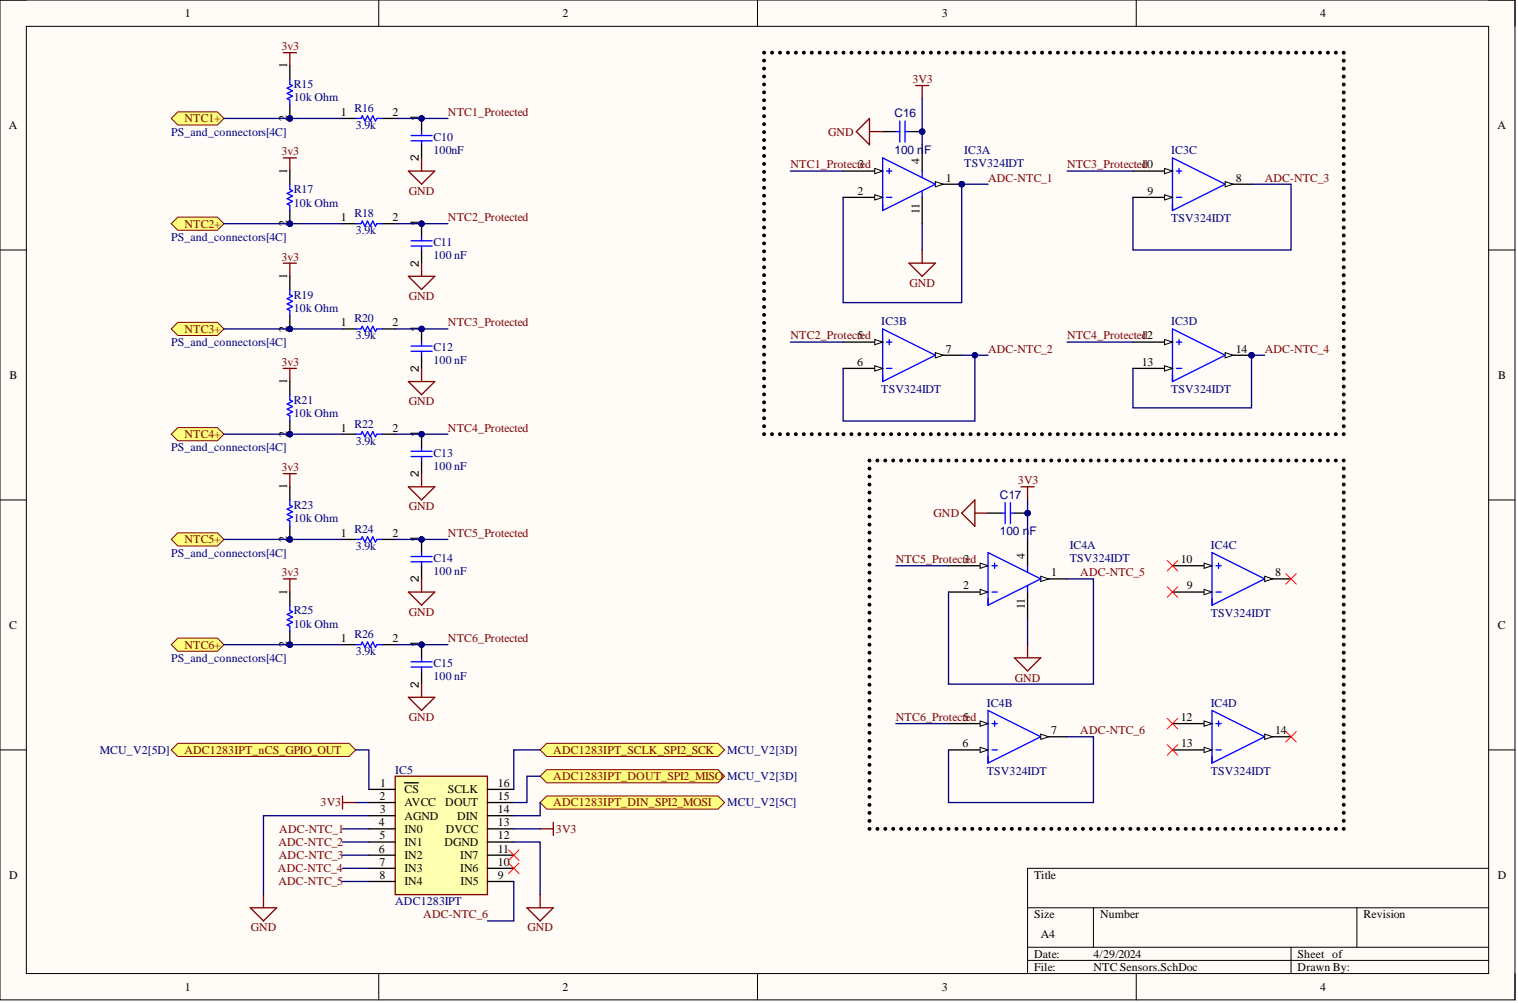
[picture p10: page 4]

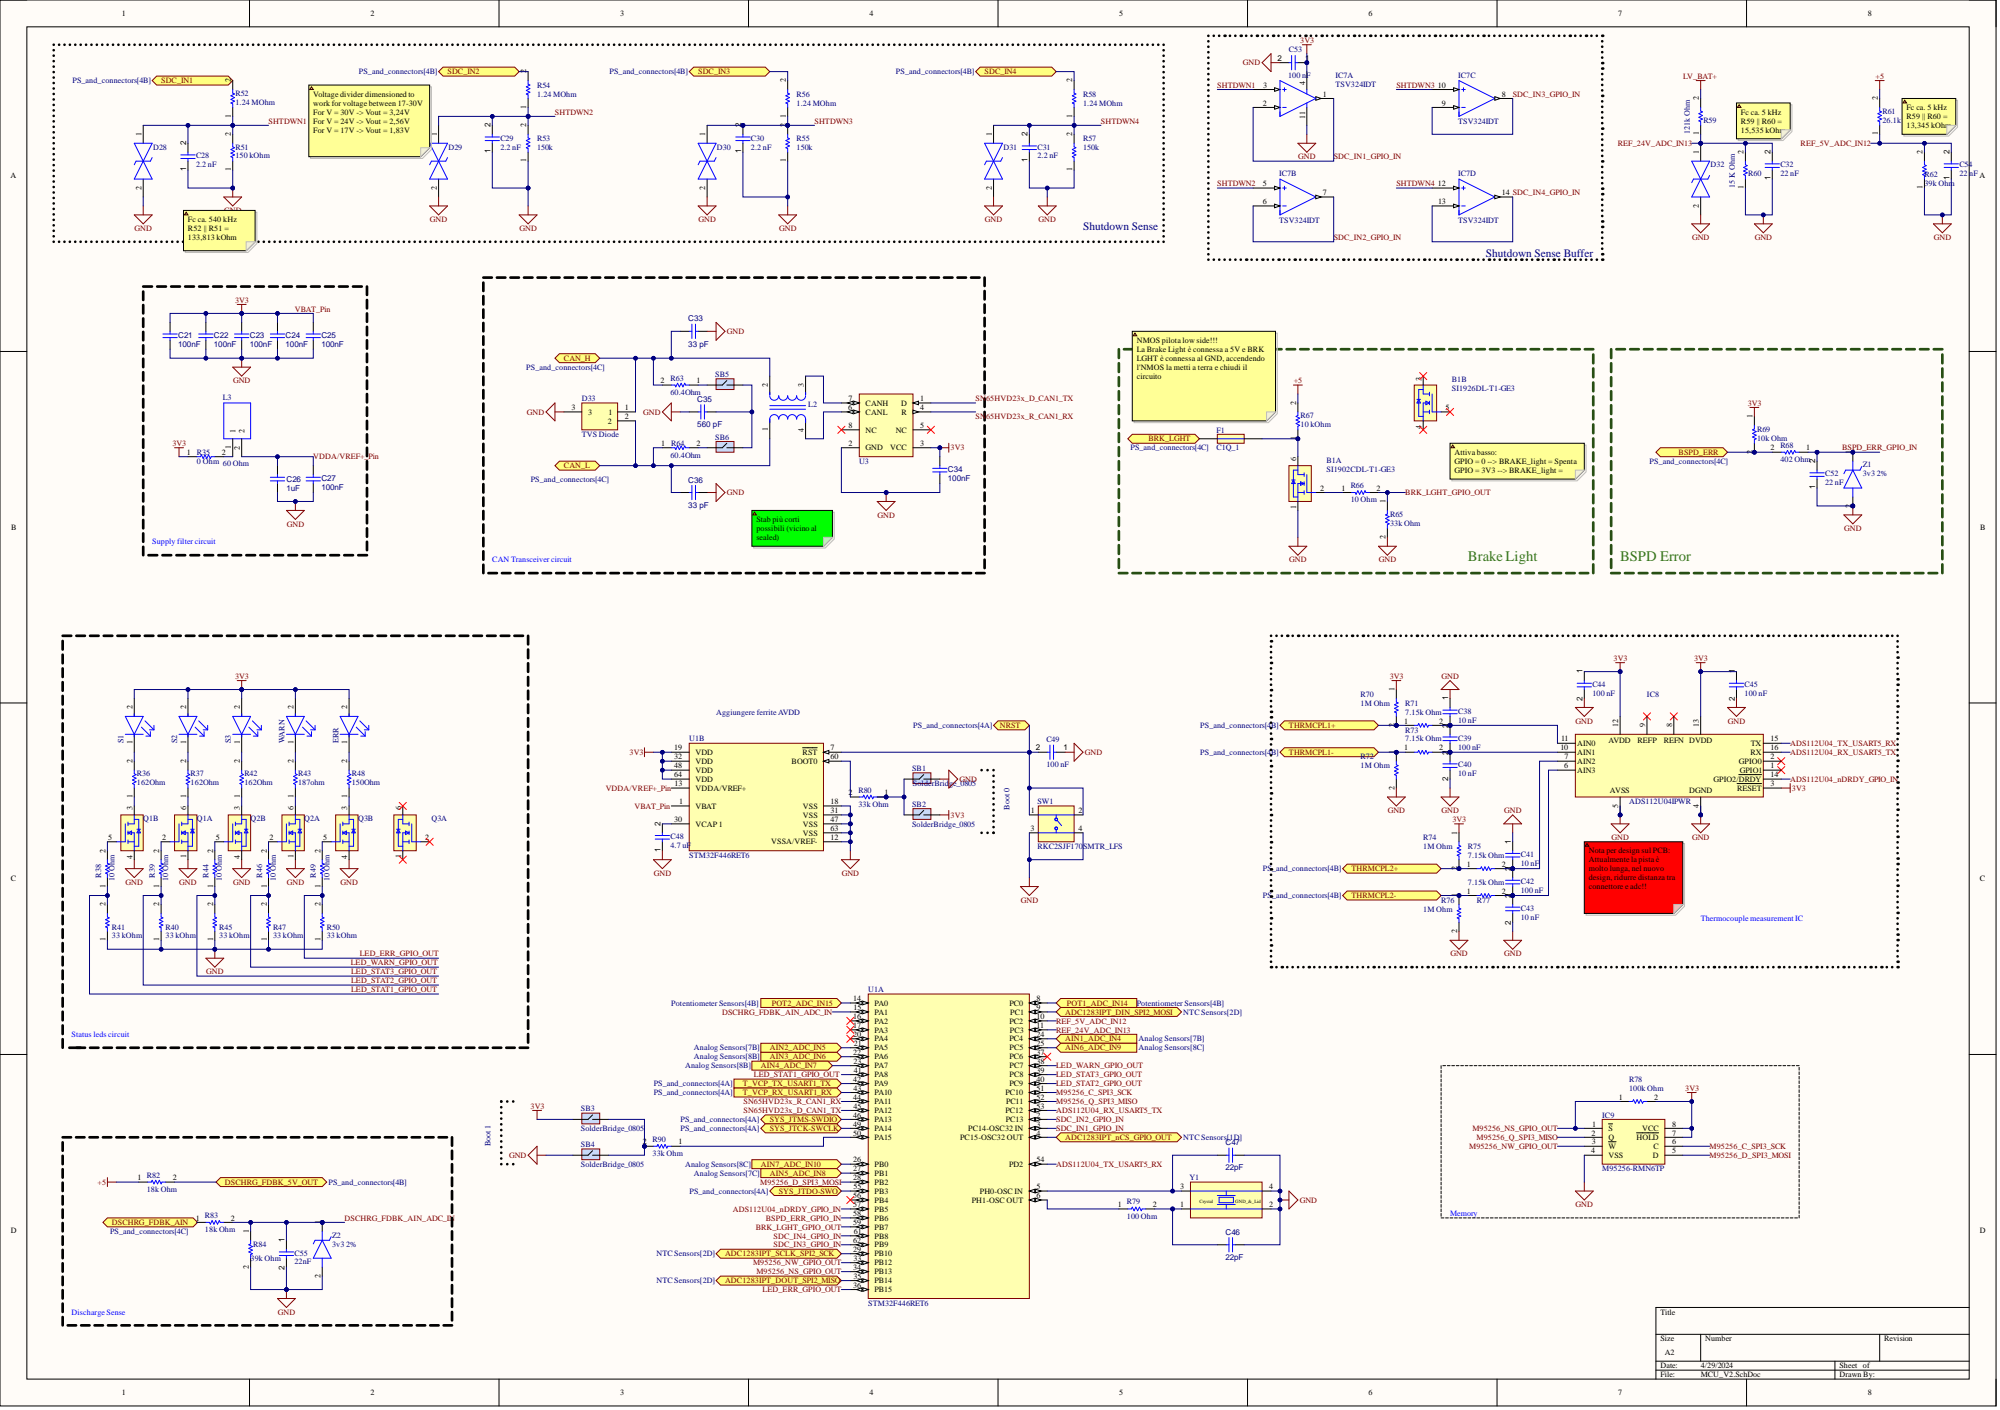
[picture p11: page 5]

Voltage divider dimensioned to
work for voltage between 17-30V
For V = 30V -> Vout = 3,24V
For V = 24V -> Vout = 2,56V
For V = 17V -> Vout = 1,83V

NMOS pilota low side!!!
La Brake Light è connessa a 5V e BRK
LGHT è connessa al GND, accendendo
l'NMOS la metti a terra e chiudi il
circuito

Nota per design sul PCB:
Attualmente la pista è
molto lunga, nel nuovo
design, ridurre distanza tra
connettore e adc!!

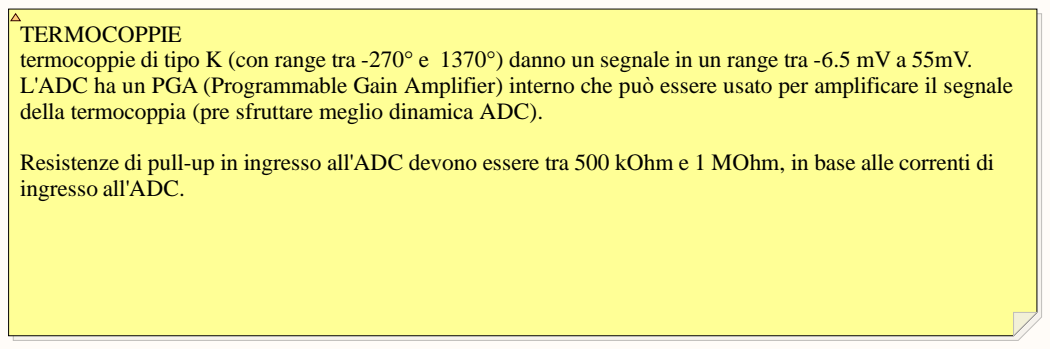
[picture p12: page 6]
File:; Commenti.SchDoc; Drawn By:

TERMOCOPPIE
termocoppie di tipo K (con range tra -270° e 1370°) danno un segnale in un range tra -6.5 mV a 55mV.
L'ADC ha un PGA (Programmable Gain Amplifier) interno che può essere usato per amplificare il segnale
della termocoppia (pre sfruttare meglio dinamica ADC).

Resistenze di pull-up in ingresso all'ADC devono essere tra 500 kOhm e 1 MOhm, in base alle correnti di
ingresso all'ADC.
