squadracorsepolito/sensorboard/Doc/Schematic.pdf

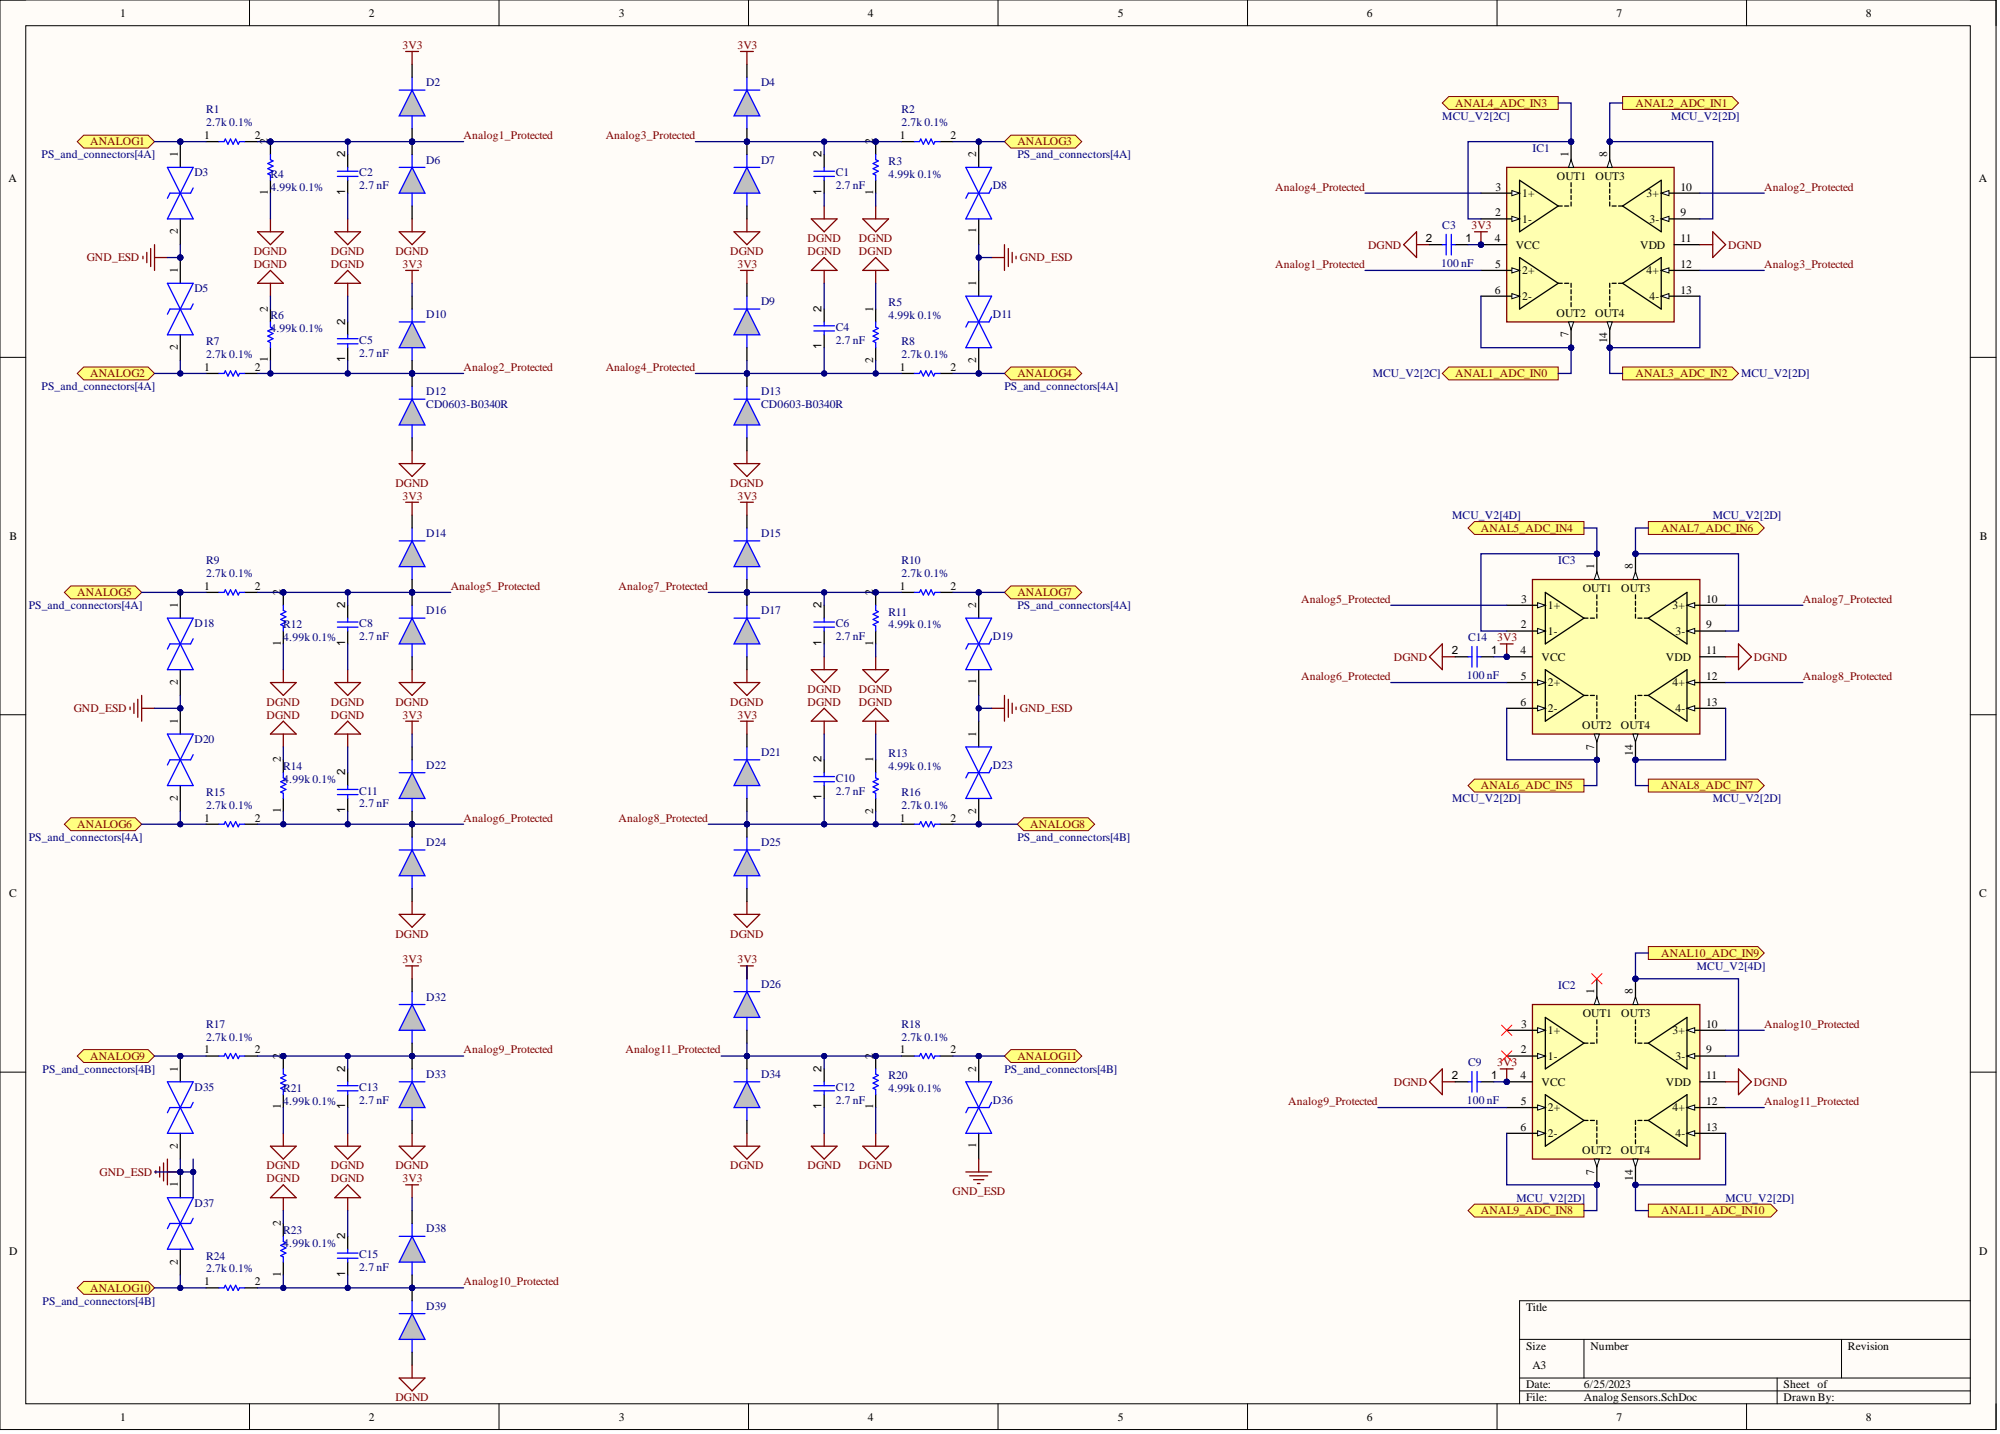
[picture p13: page 1]

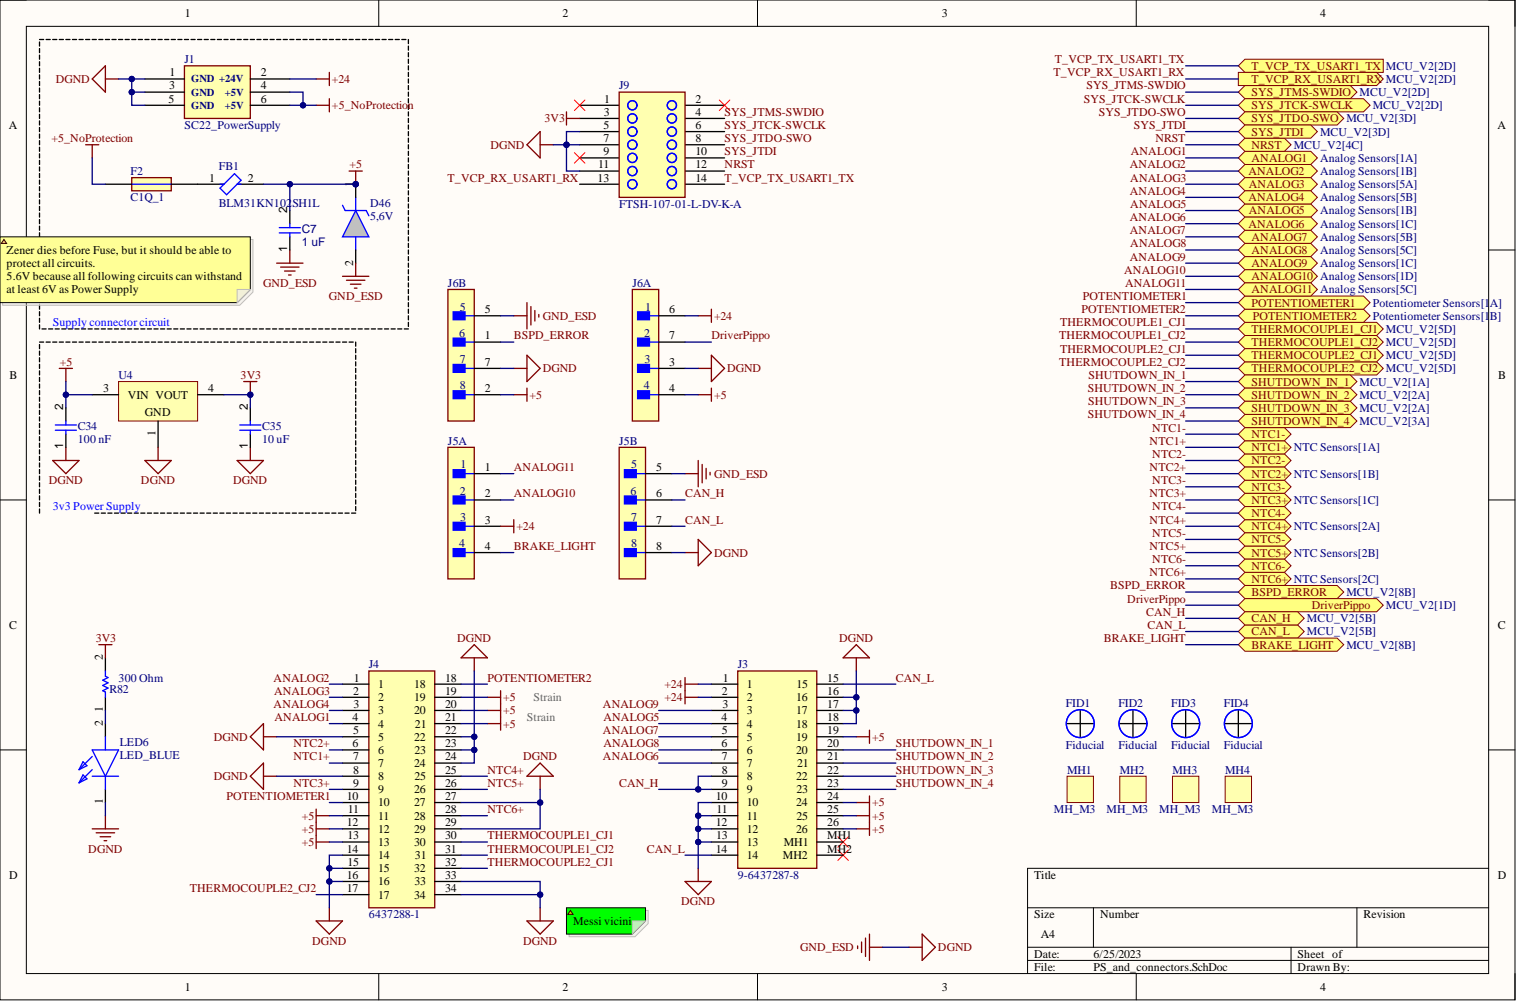
[picture p14: page 2]
or circu; wer Su; g Sen; g Sen g Sen; g Sen g Sen g Sen; 2 MCU; TC Sen; 1 MCU 2 MCU 1 MCU; ometer Sen; N_IN_4 NTC1- NTC1+ NTC2- NTC2+ NTC3- NTC3+ NTC4-; 1 MCU 2 MCU 3 MCU N_IN_4 MCU; ] BRAKE_LIGHT; O MCU; T MCU; X MCU _RX MCU; before Fu; tect al; l circu se al; g circu; s can

1 5
1 6
1 7 | | 3 4

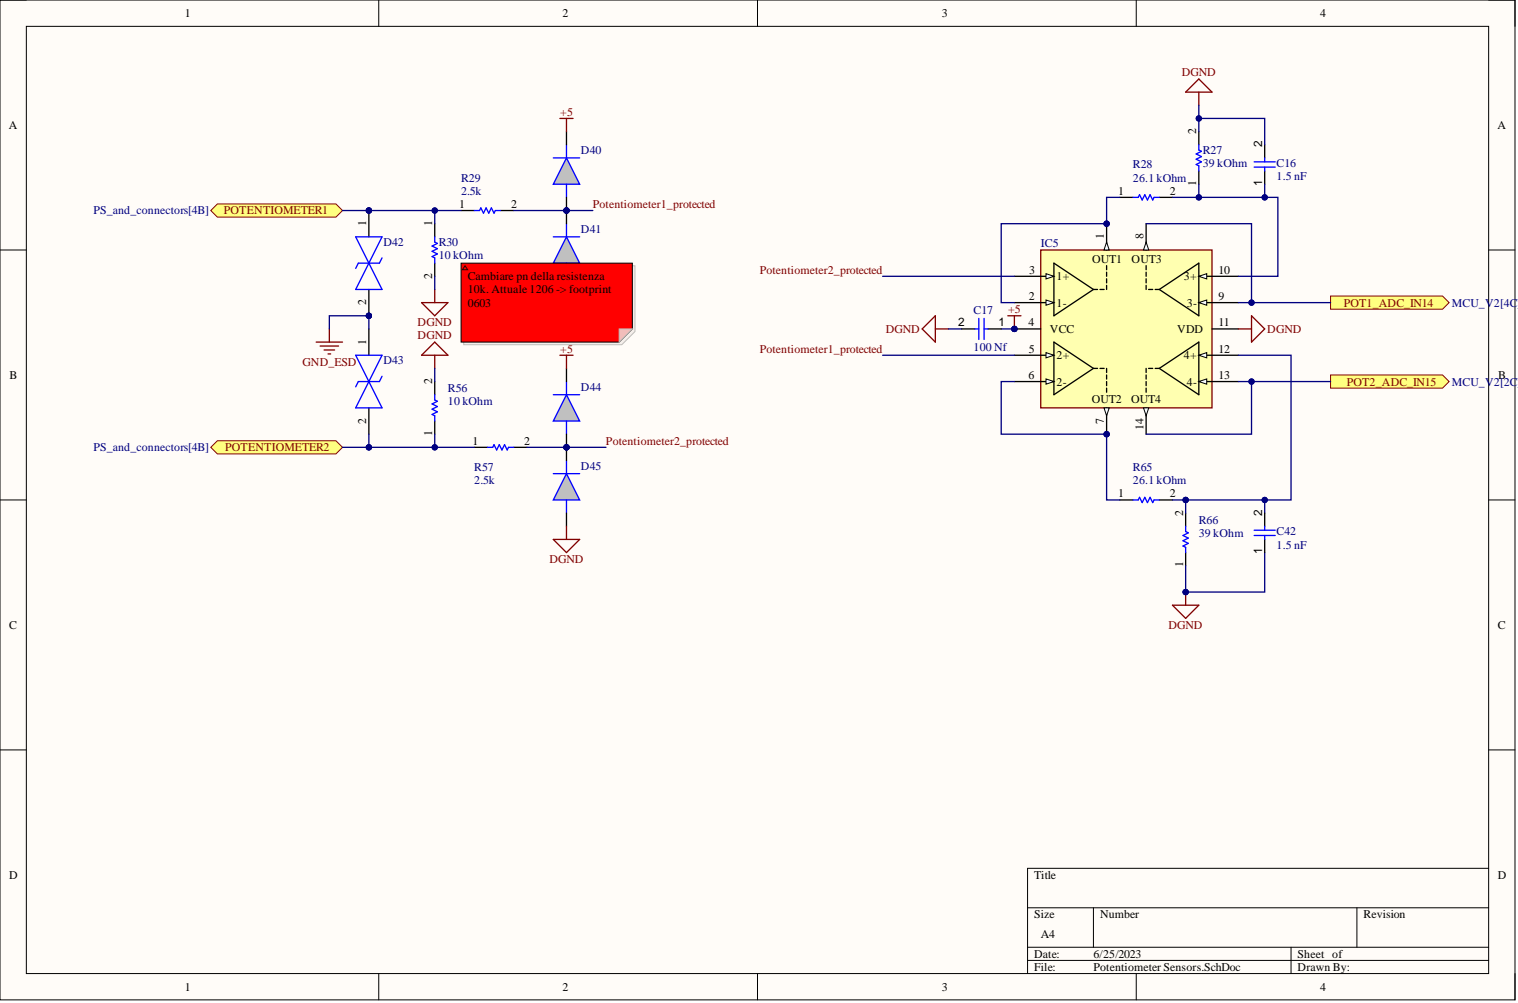
[picture p15: page 3]

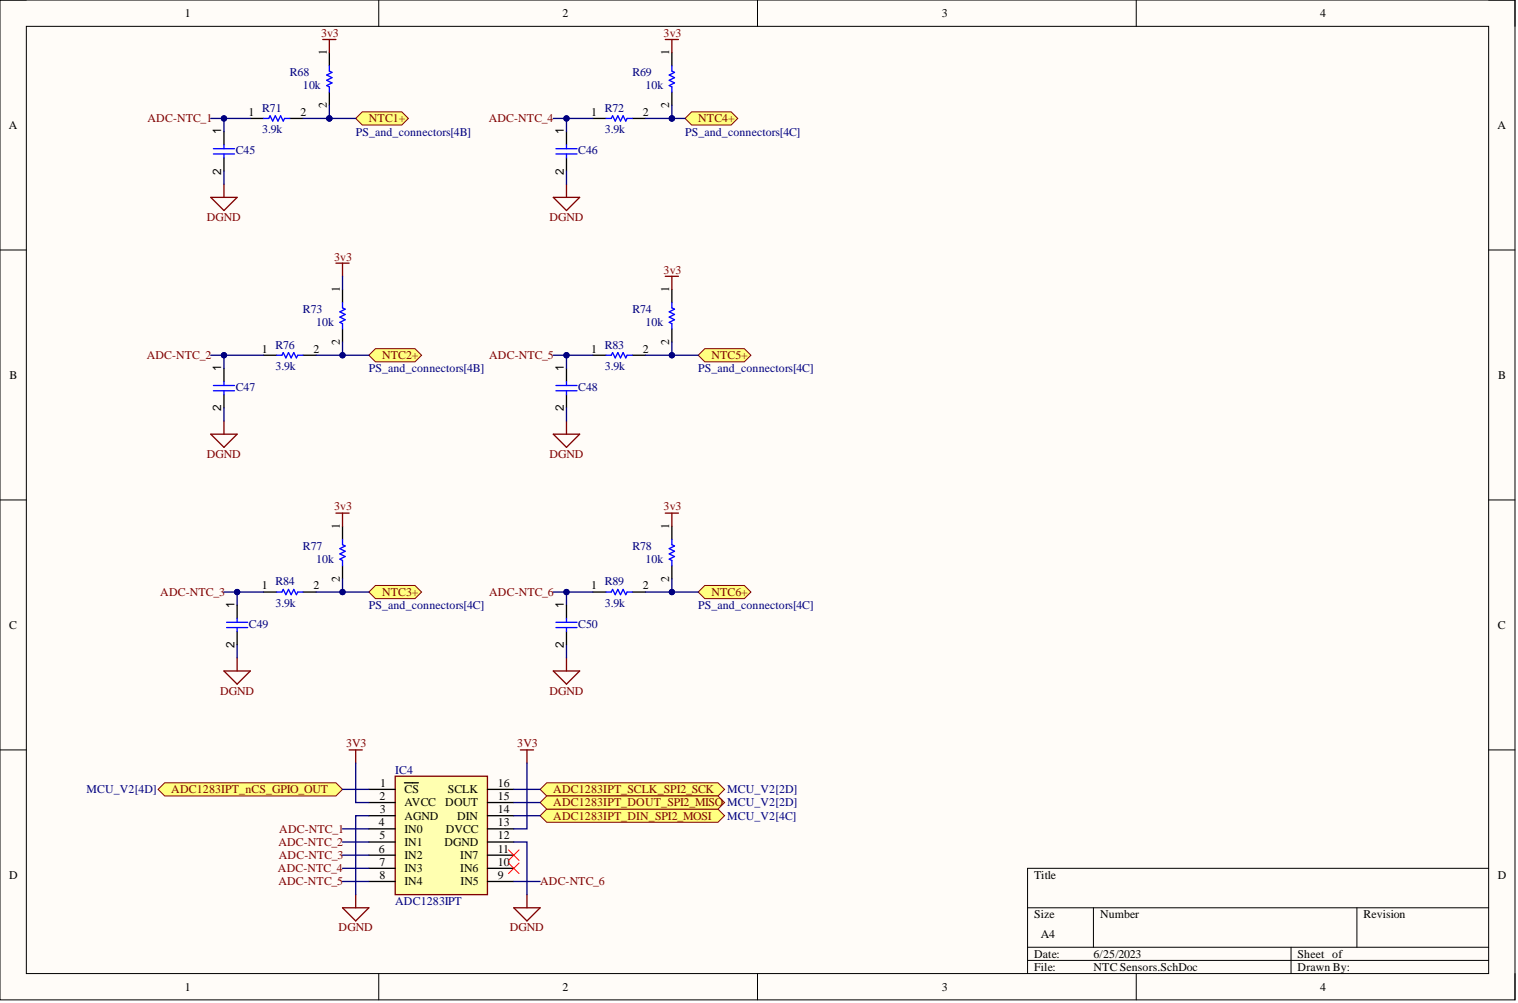
[picture p16: page 4]

AGND 3

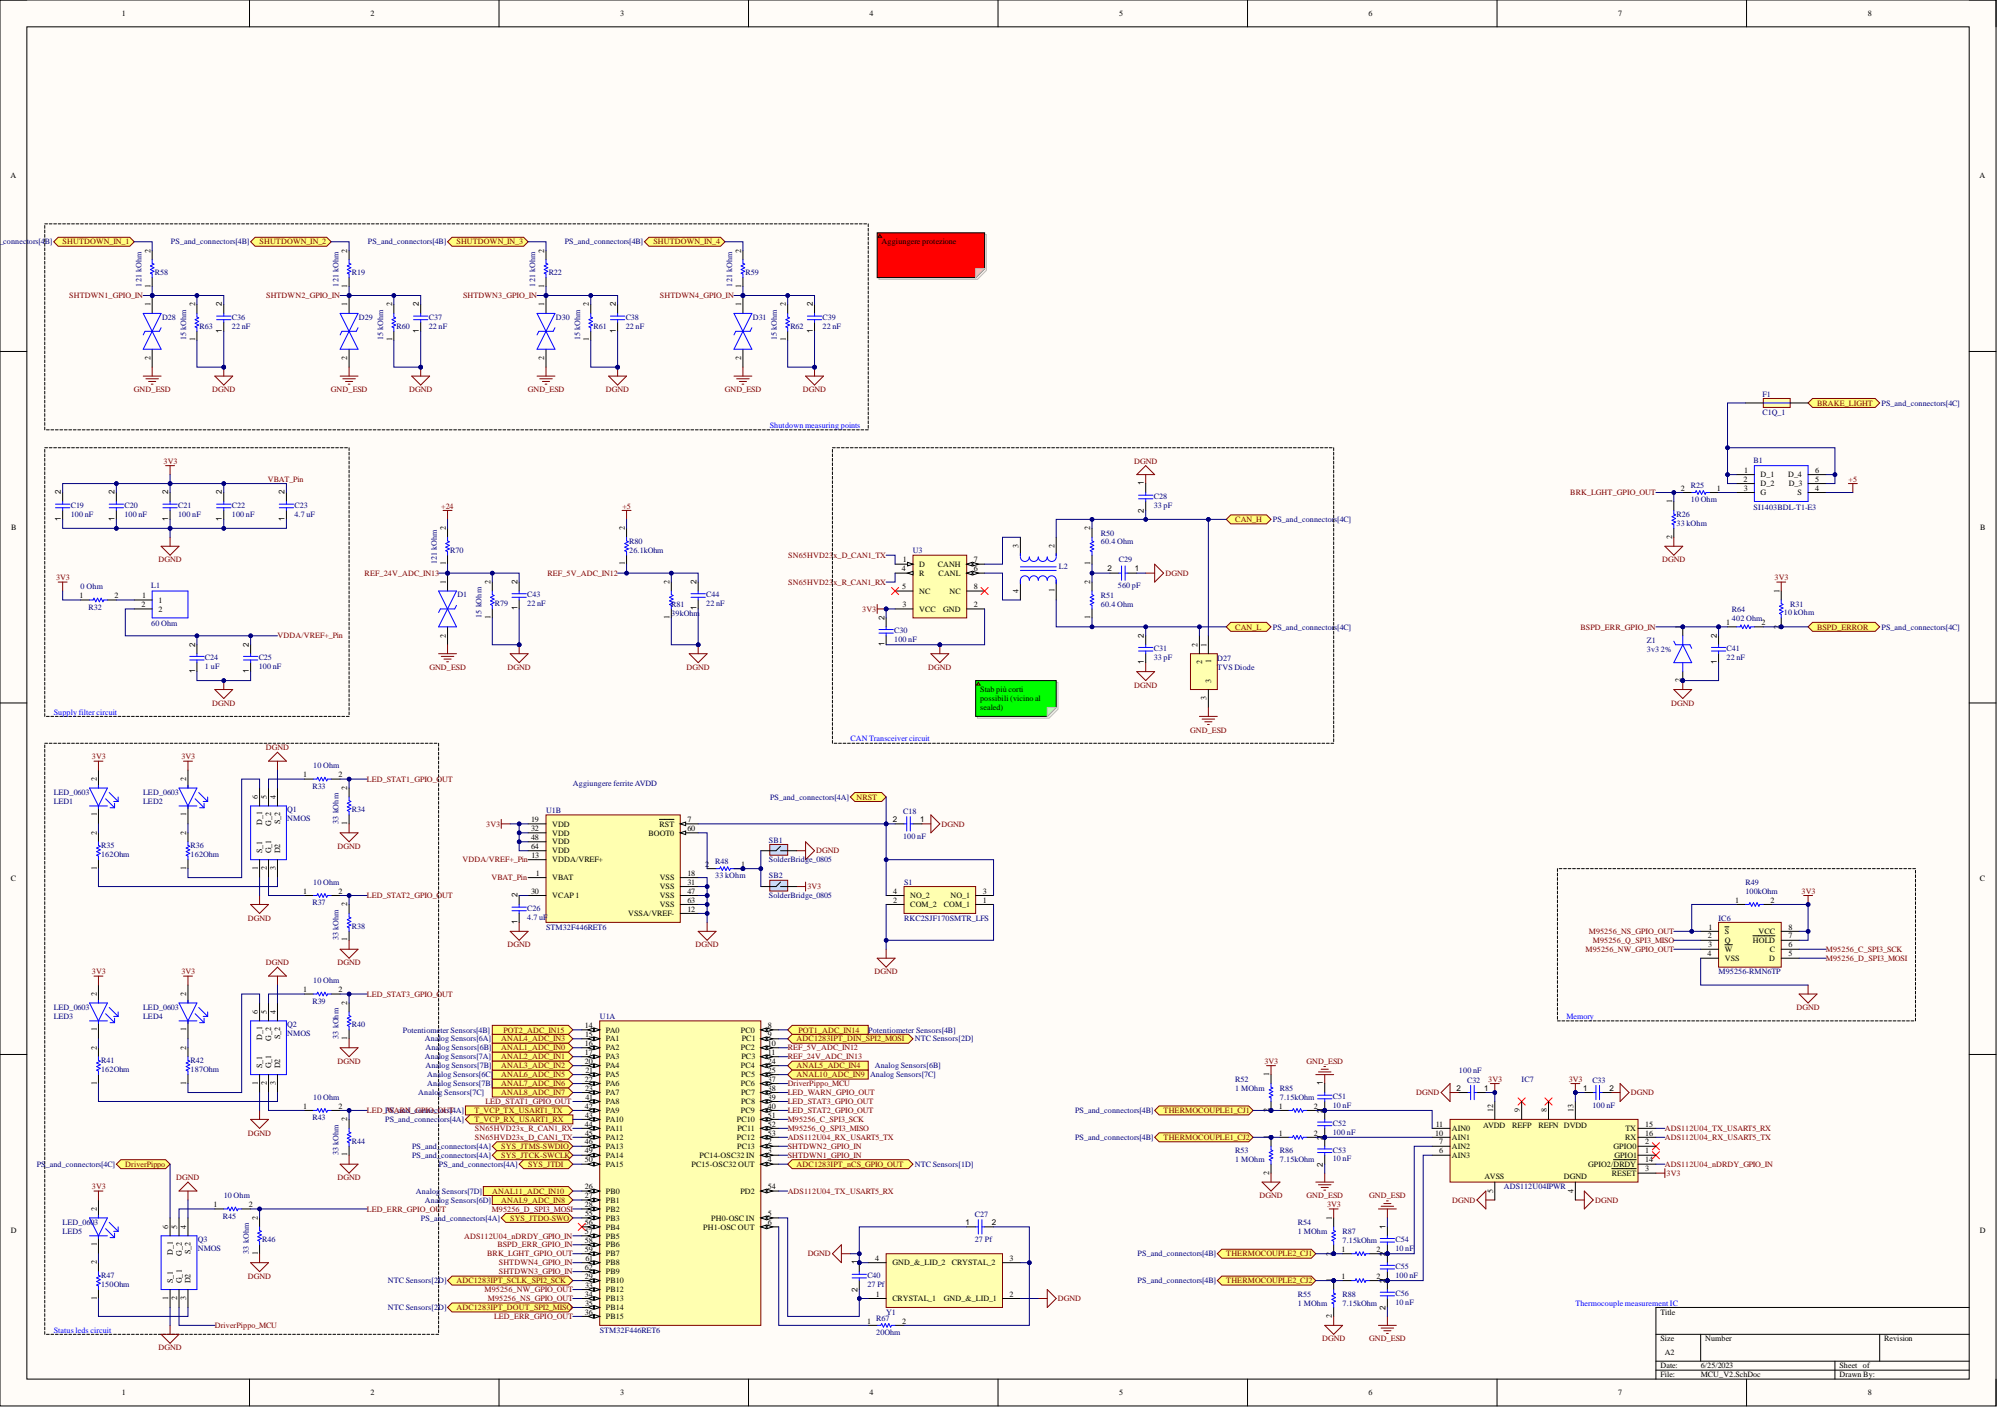
[picture p17: page 5]

CRYSTAL_2 | 3 GND_&_LID_2 4
