squadracorsepolito/sensorboard/Core/Src/main.c

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
/* Includes ------------------------------------------------------------------*/
#include "main.h"
#include "adc.h"
#include "can.h"
#include "dma.h"
#include "iwdg.h"
#include "spi.h"
#include "tim.h"
#include "usart.h"
#include "gpio.h"

/* USER CODE BEGIN Includes */
// clang-format off
#include "conf.h"
// clang-format on
#include "bsp.h"
#include "can_send_timebase.h"
#include "can_utils.h"
#include "logger_wrapper.h"
#include "stdio.h"
#include "string.h"
/* USER CODE END Includes */


/* USER CODE BEGIN PV */
char buf[100] = {};
/* USER CODE END PV */

void SystemClock_Config(void);
/**
  * @brief  The application entry point.
  * @retval int
  */
int main(void)
{

  /* MCU Configuration--------------------------------------------------------*/

  /* Reset of all peripherals, Initializes the Flash interface and the Systick. */
  HAL_Init();

  /* Configure the system clock */
  SystemClock_Config();

  /* Initialize all configured peripherals */
  MX_GPIO_Init();
  MX_DMA_Init();
  MX_TIM2_Init();
  MX_ADC1_Init();
  MX_CAN1_Init();
  MX_SPI2_Init();
  MX_SPI3_Init();
  MX_UART5_Init();
  MX_USART1_UART_Init();
  MX_ADC3_Init();
  MX_TIM12_Init();
  MX_TIM6_Init();
  MX_TIM7_Init();
  MX_IWDG_Init();
  /* USER CODE BEGIN 2 */
    logger_init();
    can_init();
    can_send_timebase_init();

    // Show at the start the type of sensorboard in function
    if (SENS_GET_TYPE() == SENS_TYPE_FRONT) {
        HAL_GPIO_WritePin(SENS_FRONT_LED_GPIO_PORT, SENS_FRONT_LED_GPIO_PIN, GPIO_PIN_SET);
        can_send_msg(MCB_SB_FRONT_HELLO_FRAME_ID);
    } else {
        HAL_GPIO_WritePin(SENS_REAR_LED_GPIO_PORT, SENS_REAR_LED_GPIO_PIN, GPIO_PIN_SET);
        can_send_msg(MCB_SB_REAR_HELLO_FRAME_ID);
    }
    uint32_t cnt1ms    = HAL_GetTick() + 1U;
    uint32_t cnt10ms   = HAL_GetTick() + 10U;
    uint32_t cnt100ms  = HAL_GetTick() + 100U;
    uint32_t cnt1000ms = HAL_GetTick() + 1000U;

    uint32_t ntc_sampling_cnt = HAL_GetTick();

  /* USER CODE END 2 */

  /* Infinite loop */
  /* USER CODE BEGIN WHILE */
    while (1) {
        //DRTB_routine();
        if (HAL_GetTick() >= cnt1ms) {
            cnt1ms += 1U;
        }
        if (HAL_GetTick() >= cnt10ms) {
            cnt10ms += 10U;

#ifdef DEBUG_SERIAL
            char *target = buf;
#ifdef DEBUG_AIN
            for (int i = 0; i < ADC_ADC1_Channel_NUM; i++) {
                float val = ADC_ADC1_getChannel_V((enum ADC_ADC1_Channel)i);
                target += sprintf(target, "%.3f,", val);
            }
#endif  // DEBUG_AIN
#ifdef DEBUG_NTC
            for (int i = 0; i < NTC_Probe_NUM; i++) {
                float val = NTC_Probe_get_resistance((enum NTC_Probe)i);
                target += sprintf(target, "%.3f,", val);
            }
#endif  // DEBUG_NTC
#ifdef DEBUG_SDC
            for (int i = 0; i < SDC_Probe_NUM; i++) {
                uint8_t val = SDC_Probe_get_status((enum SDC_Probe)i);
                target += sprintf(target, "%u,", val);
            }
#endif  // DEBUG_SDC
#ifdef DEBUG_BSPD
            target += sprintf(target, "%u,", BSPD_DEV_IS_IN_ERR());
#endif  // DEBUG_BSPD
#ifdef DEBUG_BRAKE_LIGHT
            target += sprintf(target, "%u,", BRAKE_LIGHT_IS_ON());
#endif  // DEBUG_BRAKE_LIGHT

            // remove last ","
            if (target > buf) {
                target--;
            }
            // add newline at the end
            target += sprintf(target, "\r\n");
            HAL_UART_Transmit(&VCP_UART_Handle, (uint8_t *)buf, strlen(buf), VCP_TX_LOG_BUF_MAX_TIMEOUT_ms);
#endif  // DEBUG_SERIAL
        }
        if (HAL_GetTick() >= cnt100ms) {
            cnt100ms += 100U;
        }
        if (HAL_GetTick() >= cnt1000ms) {
            cnt1000ms += 1000U;
            // Show I'm Alive by blinking sens type led
            if (SENS_GET_TYPE() == SENS_TYPE_FRONT) {
                HAL_GPIO_TogglePin(SENS_FRONT_LED_GPIO_PORT, SENS_FRONT_LED_GPIO_PIN);
            } else {
                HAL_GPIO_TogglePin(SENS_REAR_LED_GPIO_PORT, SENS_REAR_LED_GPIO_PIN);
            }
        }
        // Run NTC Probes sampling
        if (HAL_GetTick() >= ntc_sampling_cnt + NTC_SAMP_PERIOD_ms) {
            ntc_sampling_cnt += NTC_SAMP_PERIOD_ms;
            NTC_Probes_sampling_routine();
        }

        can_send_timebase_routine();
        logger_routine();

    /* USER CODE END WHILE */

    /* USER CODE BEGIN 3 */
        HAL_IWDG_Refresh(&hiwdg);  // refresh watchdog ~10ms timeout
    }                              // end while(1)
  /* USER CODE END 3 */
}

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
