squadracorsepolito/sensorboard/sensorboard.ioc

Mcu.UserName=STM32F446RETx
PA0-WKUP.GPIO_Label=POT2_ADC_IN15
PA0-WKUP.Signal=ADCx_IN0
PA1.GPIO_Label=DSCHRG_FDBK_AIN_ADC_IN
PA1.Signal=ADCx_IN1
PA10.GPIO_Label=T_VCP_RX_USART1_RX
PA10.Signal=USART1_RX
PA11.GPIO_Label=SN65HVD23x_R_CAN1_RX
PA11.Signal=CAN1_RX
PA12.GPIO_Label=SN65HVD23x_D_CAN1_TX
PA12.Signal=CAN1_TX
PA13.Signal=SYS_JTMS-SWDIO
PA14.Signal=SYS_JTCK-SWCLK
PA15.GPIO_Label=SENS_TYPE
PA15.Signal=GPIO_Input
PA5.GPIO_Label=AIN2_ADC_IN5
PA5.Signal=ADCx_IN5
PA6.GPIO_Label=AIN3_ADC_IN6
PA6.Signal=ADCx_IN6
PA7.GPIO_Label=AIN4_ADC_IN7
PA7.Signal=ADCx_IN7
PA8.GPIO_Label=LED_STAT1_GPIO_OUT
PA8.Signal=GPIO_Output
PA9.GPIO_Label=T_VCP_TX_USART1_TX
PA9.Signal=USART1_TX
PB0.GPIO_Label=AIN7_ADC_IN10
PB0.Signal=ADCx_IN8
PB1.GPIO_Label=AIN5_ADC_IN8
PB1.Signal=ADCx_IN9
PB10.GPIO_Label=ADC1283IPT_SCLK_SPI2_SCK
PB10.Signal=SPI2_SCK
PB12.GPIO_Label=M95256_nW_GPIO_OUT
PB12.Signal=GPIO_Output
PB13.GPIO_Label=M95256_nS_GPIO_OUT
PB13.Signal=GPIO_Output
PB14.GPIO_Label=ADC1283IPT_DOUT_SPI2_MISO
PB14.Signal=SPI2_MISO
PB15.GPIO_Label=LED_ERR_GPIO_OUT
PB15.Signal=S_TIM12_CH2
PB2.GPIO_Label=M95256_D_SPI3_MOSI
PB2.Signal=SPI3_MOSI
PB3.Signal=SYS_JTDO-SWO
PB5.GPIO_Label=ADS112U04_nDRDY_GPIO_IN
PB5.Signal=GPXTI5
PB6.GPIO_Label=BSPD_ERR_GPIO_IN
PB6.Signal=GPIO_Input
PB7.GPIO_Label=BRK_LGHT_GPIO_OUT
PB7.Signal=GPIO_Output
PB8.GPIO_Label=SDC_IN4_GPIO_IN
PB8.Signal=GPIO_Input
PB9.GPIO_Label=SDC_IN3_GPIO_IN
PB9.Signal=GPIO_Input
PC0.GPIO_Label=POT1_ADC_IN14
PC0.Signal=ADCx_IN10
PC1.GPIO_Label=ADC1283IPT_DIN_SPI2_MOSI
PC1.Signal=SPI2_MOSI
PC10.GPIO_Label=M95256_C_SPI3_SCK
PC10.Signal=SPI3_SCK
PC11.GPIO_Label=M95256_Q_SPI3_MISO
PC11.Signal=SPI3_MISO
PC12.GPIO_Label=ADS112U04_RX_UART5_TX
PC12.Signal=UART5_TX
PC13.GPIO_Label=SDC_IN2_GPIO_IN
PC13.Signal=GPIO_Input
PC14-OSC32_IN.GPIO_Label=SDC_IN1_GPIO_IN
PC14-OSC32_IN.Signal=GPIO_Input
PC15-OSC32_OUT.GPIO_Label=ADC1283IPT_nCS_GPIO_OUT
PC15-OSC32_OUT.Signal=GPIO_Output
PC2.GPIO_Label=REF_5V_ADC_IN12
PC2.Signal=ADCx_IN12
PC3.GPIO_Label=REF_24V_ADC_IN13
PC3.Signal=ADCx_IN13
PC4.GPIO_Label=AIN1_ADC_IN4
PC4.Signal=ADCx_IN14
PC5.GPIO_Label=AIN6_ADC_IN9 
PC5.Signal=ADCx_IN15
PC7.GPIO_Label=LED_WARN_GPIO_OUT
PC7.Signal=GPIO_Output
PC8.GPIO_Label=LED_STAT3_GPIO_OUT
PC8.Signal=GPIO_Output
PC9.GPIO_Label=LED_STAT2_GPIO_OUT
PC9.Signal=GPIO_Output
PD2.GPIO_Label=ADS112U04_TX_UART5_RX
PD2.Signal=UART5_RX
PH0-OSC_IN.Signal=RCC_OSC_IN
PH1-OSC_OUT.Signal=RCC_OSC_OUT
