squadracorsepolito/sensorboard/Core/Inc/main.h

#define SDC_IN2_GPIO_IN_Pin GPIO_PIN_13
#define SDC_IN2_GPIO_IN_GPIO_Port GPIOC
#define SDC_IN1_GPIO_IN_Pin GPIO_PIN_14
#define SDC_IN1_GPIO_IN_GPIO_Port GPIOC
#define ADC1283IPT_nCS_GPIO_OUT_Pin GPIO_PIN_15
#define ADC1283IPT_nCS_GPIO_OUT_GPIO_Port GPIOC
#define POT1_ADC_IN14_Pin GPIO_PIN_0
#define POT1_ADC_IN14_GPIO_Port GPIOC
#define ADC1283IPT_DIN_SPI2_MOSI_Pin GPIO_PIN_1
#define ADC1283IPT_DIN_SPI2_MOSI_GPIO_Port GPIOC
#define REF_5V_ADC_IN12_Pin GPIO_PIN_2
#define REF_5V_ADC_IN12_GPIO_Port GPIOC
#define REF_24V_ADC_IN13_Pin GPIO_PIN_3
#define REF_24V_ADC_IN13_GPIO_Port GPIOC
#define POT2_ADC_IN15_Pin GPIO_PIN_0
#define POT2_ADC_IN15_GPIO_Port GPIOA
#define DSCHRG_FDBK_AIN_ADC_IN_Pin GPIO_PIN_1
#define DSCHRG_FDBK_AIN_ADC_IN_GPIO_Port GPIOA
#define AIN2_ADC_IN5_Pin GPIO_PIN_5
#define AIN2_ADC_IN5_GPIO_Port GPIOA
#define AIN3_ADC_IN6_Pin GPIO_PIN_6
#define AIN3_ADC_IN6_GPIO_Port GPIOA
#define AIN4_ADC_IN7_Pin GPIO_PIN_7
#define AIN4_ADC_IN7_GPIO_Port GPIOA
#define AIN1_ADC_IN4_Pin GPIO_PIN_4
#define AIN1_ADC_IN4_GPIO_Port GPIOC
#define AIN6_ADC_IN9_Pin GPIO_PIN_5
#define AIN6_ADC_IN9_GPIO_Port GPIOC
#define AIN7_ADC_IN10_Pin GPIO_PIN_0
#define AIN7_ADC_IN10_GPIO_Port GPIOB
#define AIN5_ADC_IN8_Pin GPIO_PIN_1
#define AIN5_ADC_IN8_GPIO_Port GPIOB
#define M95256_D_SPI3_MOSI_Pin GPIO_PIN_2
#define M95256_D_SPI3_MOSI_GPIO_Port GPIOB
#define ADC1283IPT_SCLK_SPI2_SCK_Pin GPIO_PIN_10
#define ADC1283IPT_SCLK_SPI2_SCK_GPIO_Port GPIOB
#define M95256_nW_GPIO_OUT_Pin GPIO_PIN_12
#define M95256_nW_GPIO_OUT_GPIO_Port GPIOB
#define M95256_nS_GPIO_OUT_Pin GPIO_PIN_13
#define M95256_nS_GPIO_OUT_GPIO_Port GPIOB
#define ADC1283IPT_DOUT_SPI2_MISO_Pin GPIO_PIN_14
#define ADC1283IPT_DOUT_SPI2_MISO_GPIO_Port GPIOB
#define LED_ERR_GPIO_OUT_Pin GPIO_PIN_15
#define LED_ERR_GPIO_OUT_GPIO_Port GPIOB
#define LED_WARN_GPIO_OUT_Pin GPIO_PIN_7
#define LED_WARN_GPIO_OUT_GPIO_Port GPIOC
#define LED_STAT3_GPIO_OUT_Pin GPIO_PIN_8
#define LED_STAT3_GPIO_OUT_GPIO_Port GPIOC
#define LED_STAT2_GPIO_OUT_Pin GPIO_PIN_9
#define LED_STAT2_GPIO_OUT_GPIO_Port GPIOC
#define LED_STAT1_GPIO_OUT_Pin GPIO_PIN_8
#define LED_STAT1_GPIO_OUT_GPIO_Port GPIOA
#define T_VCP_TX_USART1_TX_Pin GPIO_PIN_9
#define T_VCP_TX_USART1_TX_GPIO_Port GPIOA
#define T_VCP_RX_USART1_RX_Pin GPIO_PIN_10
#define T_VCP_RX_USART1_RX_GPIO_Port GPIOA
#define SN65HVD23x_R_CAN1_RX_Pin GPIO_PIN_11
#define SN65HVD23x_R_CAN1_RX_GPIO_Port GPIOA
#define SN65HVD23x_D_CAN1_TX_Pin GPIO_PIN_12
#define SN65HVD23x_D_CAN1_TX_GPIO_Port GPIOA
#define SENS_TYPE_Pin GPIO_PIN_15
#define SENS_TYPE_GPIO_Port GPIOA
#define M95256_C_SPI3_SCK_Pin GPIO_PIN_10
#define M95256_C_SPI3_SCK_GPIO_Port GPIOC
#define M95256_Q_SPI3_MISO_Pin GPIO_PIN_11
#define M95256_Q_SPI3_MISO_GPIO_Port GPIOC
#define ADS112U04_RX_UART5_TX_Pin GPIO_PIN_12
#define ADS112U04_RX_UART5_TX_GPIO_Port GPIOC
#define ADS112U04_TX_UART5_RX_Pin GPIO_PIN_2
#define ADS112U04_TX_UART5_RX_GPIO_Port GPIOD
#define ADS112U04_nDRDY_GPIO_IN_Pin GPIO_PIN_5
#define ADS112U04_nDRDY_GPIO_IN_GPIO_Port GPIOB
#define BSPD_ERR_GPIO_IN_Pin GPIO_PIN_6
#define BSPD_ERR_GPIO_IN_GPIO_Port GPIOB
#define BRK_LGHT_GPIO_OUT_Pin GPIO_PIN_7
#define BRK_LGHT_GPIO_OUT_GPIO_Port GPIOB
#define SDC_IN4_GPIO_IN_Pin GPIO_PIN_8
#define SDC_IN4_GPIO_IN_GPIO_Port GPIOB
#define SDC_IN3_GPIO_IN_Pin GPIO_PIN_9
#define SDC_IN3_GPIO_IN_GPIO_Port GPIOB
