squadracorsepolito/sensorboard/Core/Inc/gpio_sensing.h

#ifndef GPIO_SENSING_H
#define GPIO_SENSING_H

#include "gpio.h"

//typedef enum {
//    SD_SENS1,
//    SD_SENS2,
//    SD_SENS3,
//    SD_SENS4,
//    BSPD_SENS,
//    GPIO_PINS_N
//} GPIO_SENS_PIN_t;
//
//GPIO_PinState gpio_sens_get(GPIO_SENS_PIN_t gpio);

#endif // GPIO_SENSING_H
