squadracorsepolito/sensorboard/Tools/serial-to-udp-translator/CONFIG_SERIAL_TO_UDP_can_errors.txt

VALUES=[ Protocol_Error_Warning Error_Passive Bus-off_error Stuff_error Form_error Acknowledgment_error Bit_recessive_error Bit_dominant_error CRC_error Rx_FIFO0_overrun_error Rx_FIFO1_overrun_error TxMailbox_0_transmit_failure_due_to_arbitration_lost TxMailbox_0_transmit_failure_due_to_transmit_error TxMailbox_1_transmit_failure_due_to_arbitration_lost TxMailbox_1_transmit_failure_due_to_transmit_error TxMailbox_2_transmit_failure_due_to_arbitration_lost TxMailbox_2_transmit_failure_due_to_transmit_error Timeout_error Peripheral_not_initialized Peripheral_not_ready Peripheral_not_started Parameter_error Internal_error Receive_Error_Counter Transmit_Error_Counter ]
NEWLINE=CRLF
SEPARATOR=,
BAUDRATE=115200
UDP_PORT=6000
SERIAL_PORT=/dev/ttyACM0
