squadracorsepolito/sensorboard/(commit log)

2023-03-12 feat: added and moved pins
    - reference 5V,24V on ADC3 chnl 12,13
    - moved LED pins by one position up
    - added TIM12_CHNL2/PWM to drive NMOS gate
    - removed ADC instance name in ADC pin labels
2023-06-27 feat: schematic
2023-07-10 feat: add stm32-cmake chore: removed backups
2023-07-10 chore: bump up adc1283 driver
2023-07-17 fix: pinout, feat: flash via can in makefile
    [adc.c, main.c, main.h, ntc.c, sensor_board.ioc]
2023-07-24 fix: changed pinout to actual hardware
    [adc.c, adc.h, anal.c, can_utils.c, main.c]
2023-10-03 chore: updated submodules and can freq to 100Hz
2024-05-19 doc: sensors DS
2024-05-23 doc: added RME sensor
2024-05-23 fix: PPS rear adc mapping
    [bsp.h]
2024-05-24 feat: logging, fix: NTC sampling, SDC feedbacks
    [adc.c, bsp.h, can_utils.c, main.c]
2024-06-02 feat: make with Makefile instead of STM32Make.make
2024-06-04 fix: CRLF -> LF at EOL
    [blt_conf.h, led.c, main.c, main.h]
2024-06-13 feat: tools configs
    [CONFIG_SERIAL_TO_UDP_can_errors.txt]
2024-12-20 fix: rm decimal print in openblt from makefile
2025-03-19 removed stm32-cmake dep
2026-06-22 feat: new pressure sensor added
2026-07-01 feat: added new pressure sensors and fixed CAN versioning problems
    [bsp.h, can_utils.c]
2026-07-05 fix: corrected new brake sensors
    [can_send_timebase.c, can_utils.c]
