squadracorsepolito/sensorboard/(notices)

Notices in the files:
Core/Src/main.c:
Copyright (c) 2023 STMicroelectronics.
All rights reserved.
This software is licensed under terms that can be found in the LICENSE file
openblt_f446re/Core/Inc/BLT/blt_conf.h:
modify it under the terms of the GNU General Public License as published by the Free
